nischayhegde/jetson_spi_to_can_x8_breakout/datasheets/README.md

# Datasheet archive

Local PDFs: **29/29 documents**, covering 26 component-library inventory part numbers plus 3 supplements.

A link is not a downloaded PDF. The status column records the actual local result. Documents may cover a family, and some are part-specific specification or characterization sheets as identified below.

| Part | Intended local filename | Document / source | Local status |
|---|---|---|---|
| MCP251863T-E/SS | MCP251863T-E_SS.pdf | [Microchip device datasheet](https://ww1.microchip.com/downloads/aemDocuments/documents/APID/ProductDocuments/DataSheets/MCP251863-Data-Sheet-DS20006624A.pdf) | present |
| ABM8G-40.000MHZ-18-D2Y-T | ABM8G-40.000MHZ-18-D2Y-T.pdf | [Abracon ABM8G family datasheet; selected options encoded in MPN](https://abracon.com/Resonators/ABM8G.pdf) | present |
| ESDONCAN1LT1G | ESDONCAN1LT1G.pdf | [onsemi ESDONCAN1 device datasheet, distributor-hosted older revision](https://www.farnell.com/datasheets/2337848.pdf) | present |
| ISO7763DWR | ISO7763DWR.pdf | [TI ISO776x family datasheet](https://www.ti.com/lit/ds/symlink/iso7763.pdf) | present |
| TMR 6-0511 | TMR_6-0511.pdf | [TRACO TMR 6 family datasheet](https://www.tracopower.com/products/tmr6.pdf) | present |
| TPS259530DSGR | TPS259530DSGR.pdf | [TI TPS2595 family datasheet](https://www.ti.com/lit/ds/symlink/tps2595.pdf) | present |
| TLV75533PDBVR | TLV75533PDBVR.pdf | [TI TLV755P family datasheet](https://www.ti.com/lit/ds/symlink/tlv755p.pdf) | present |
| CL10C270JB8NNNC | CL10C270JB8NNNC.pdf | [Samsung exact-part specification sheet, distributor-hosted copy; 27 pF C0G 50 V +/-5%, 0603](https://www1.futureelectronics.com/doc/Samsung%20Electro-Mechanics/CL10C270JB8NNNC.pdf) | present |
| CC0603KRX7R9BB104 | CC0603KRX7R9BB104.pdf | [YAGEO exact-part specification sheet](https://yageogroup.com/download/specsheet/CC0603KRX7R9BB104) | present |
| CGA3E1X7R1E105K080AC | CGA3E1X7R1E105K080AC.pdf | [TDK CGA series specification, distributor-hosted copy listing selected MPN](https://www.farnell.com/datasheets/1735392.pdf) | present |
| CL21B106KOQNNNE | CL21B106KOQNNNE.pdf | [Samsung CL series datasheet linked by DigiKey for selected MPN](https://mm.digikey.com/Volume0/opasdata/d220001/medias/docus/926/CL_Series_MLCC_ds.pdf) | present |
| CC0603KRX7R9BB103 | CC0603KRX7R9BB103.pdf | [YAGEO exact-part specification sheet](https://yageogroup.com/download/specsheet/CC0603KRX7R9BB103) | present |
| RC1206FR-07120RL | RC1206FR-07120RL.pdf | [YAGEO RC_L family datasheet](https://yageogroup.com/content/datasheet/asset/file/PYU-RC_GROUP_51_ROHS_L) | present |
| RC0603FR-0710KL | RC0603FR-0710KL.pdf | [YAGEO RC_L family datasheet](https://yageogroup.com/content/datasheet/asset/file/PYU-RC_GROUP_51_ROHS_L) | present |
| RC0603FR-0733RL | RC0603FR-0733RL.pdf | [YAGEO RC_L family datasheet](https://yageogroup.com/content/datasheet/asset/file/PYU-RC_GROUP_51_ROHS_L) | present |
| CRCW06031K21FKEA | CRCW06031K21FKEA.pdf | [Vishay D/CRCW e3 family datasheet](https://www.vishay.com/doc?20035=) | present |
| B3B-XH-A | B3B-XH-A.pdf | [JST XH series specification and dimensions](https://www.jst-mfg.com/product/pdf/eng/eXH.pdf) | present |
| B2B-XH-A | B2B-XH-A.pdf | [JST XH series specification and dimensions](https://www.jst-mfg.com/product/pdf/eng/eXH.pdf) | present |
| M20-9982046 | M20-9982046.pdf | [Harwin M20 component specification; also download M20-998 drawing](https://content.harwin.com/m/7d31e750480889aa/original/C001-C001XX-Component-Specification-M20-Series-2-54mm-pitch-PCB-connectors.pdf) | present |
| 0466001.NR | 0466001.NR.pdf | [Littelfuse 466 family datasheet, distributor-hosted copy including the selected 1 A row; current manufacturer link in BOM/symbol](https://www.farnell.com/datasheets/3741073.pdf) | present |
| AO3401A | AO3401A.pdf | [Alpha & Omega Semiconductor AO3401A Rev. 3.1 (December 2023), original manufacturer datasheet](https://www.aosmd.com/sites/default/files/res/datasheets/AO3401A.pdf) | present |
| BZT52C6V8-13-F | BZT52C6V8-13-F.pdf | [Diodes Incorporated DS18004 Rev. 32-2 (June 2008), DigiKey-hosted original manufacturer family datasheet including 6.8 V and -13-F packaging; current manufacturer sheet linked in BOM/symbol](https://media.digikey.com/pdf/Data%20Sheets/Diodes%20PDFs/BZT52CV0%20-%20BZT52C39.pdf) | present |
| 74LVC08APW,118 | 74LVC08APW_118.pdf | [Nexperia quad AND gate datasheet Rev. 11, distributor-hosted copy; latest Rev. 12 linked in symbol/BOM](https://store.comet.bg/download-file.php?id=14759) | present |
| 74AHC30PW,118 | 74AHC30PW_118.pdf | [Nexperia 74AHC/74AHCT30 older manufacturer datasheet from public mirror; current Rev. 8 reviewed online and linked in BOM/symbol](https://docs.ampnuts.ru/nexperia.com.datasheet/74AHC_AHCT30.pdf) | present |
| 74LVC32APW,118 | 74LVC32APW_118.pdf | [NXP 74LVC32A Rev. 5 (2011), distributor-hosted predecessor-brand datasheet; current Nexperia Rev. 11 linked in BOM/symbol](https://www.farnell.com/datasheets/1645516.pdf) | present |
| 74LVC04AT14-13 | 74LVC04AT14-13.pdf | [Diodes Incorporated hex inverter datasheet](https://www.diodes.com/assets/Datasheets/74LVC04A.pdf) | present |
| Supplement | M20-998_Drawing.pdf | [Harwin M20-998 family dimensional drawing](https://content.harwin.com/asset/1590d228-db5c-4836-ab0c-0f146730b624/DRG-00478-Technical-Drawing-Datasheet-M20-998-pdf.pdf) | present |
| Supplement | MCP251863_Board_Design_Hints.pdf | [Microchip board design application note](https://ww1.microchip.com/downloads/aemDocuments/documents/APID/ApplicationNotes/ApplicationNotes/MCP251863-Application-Note-00004560A.pdf) | present |
| Supplement | MOSFET_Reverse_Protection_TI.pdf | [TI Basics of Ideal Diodes, P-channel reverse-hookup topology and reverse-current limitations](https://www.ti.com/lit/an/slvae57/slvae57.pdf) | present |

## Download / retry

Run from the repository root:

```powershell
python .\datasheets\download_datasheets.py
```

The downloader uses ordinary system proxy settings; it does not bypass the environment network restrictions. It validates PDF header/trailer markers, preserves valid existing files, and records source URLs, timestamps, file sizes, hashes and errors. Full PDF rendering and electrical applicability still need review.

## Latest attempt

All listed PDFs are present.
