nischayhegde/jetson_spi_to_can_x8_breakout/review/MCP251863_Board_Design_Hints.txt

=== PDF PAGE 1 ===
 MCP251863 Schematic Hints
 MCP251863 Board Design Hints
Introduction
This application note covers hints on how to design a PCB for the MCP251863.
Included are recommendations to achieve a low level of emissions and best practices for other parts of the PCB.
A good EMC design requires more knowledge than what can be put into a short application note. Unlike many other
design issues, EMC is not an area where it is possible to list a set of rules. EMC compliance cannot be guaranteed
by design; it has to be tested.
© 2022 Microchip Technology Inc.
and its subsidiaries
 Manual
00004560A-page 1

=== PDF PAGE 2 ===
Table of Contents
Introduction.....................................................................................................................................................1
1. 
Getting Started........................................................................................................................................3
2. 
Examples - Schematic Excerpts MCP251863........................................................................................ 4
3. 
Related Documents.................................................................................................................................6
4. 
Revision History...................................................................................................................................... 7
Microchip Information.....................................................................................................................................8
The Microchip Website............................................................................................................................8
Product Change Notification Service...................................................................................................... 8
Customer Support...................................................................................................................................8
Microchip Devices Code Protection Feature...........................................................................................8
Legal Notice............................................................................................................................................ 8
Trademarks............................................................................................................................................. 9
Quality Management System................................................................................................................10
Worldwide Sales and Service................................................................................................................11
 MCP251863 schematic hints
© 2022 Microchip Technology Inc.
and its subsidiaries
 Manual
00004560A-page 2

=== PDF PAGE 3 ===
1.
Getting Started
Selecting the correct crystal oscillator or ceramic resonator components depends on multiple factors that are
application-dependent. Please review Section 6.7 “Clocking Guidelines” of the “PIC32 Family Reference Manual”
(DS61112) and refer to the application notes listed in Section Related Documents.
The following crystals, together with 18 pF load capacitors, were successfully used in two of our evaluation
boards: ABM8G-40.000MHZ-18-D2Y-T and ABM8G-20.000MHZ-18-D2Y-T. The following crystals, together with
6 pF load capacitors, were successfully used in our evaluation boards: XRCGE20M000F3A1AR0 and
XRCGB40M000F5A00R0. The CSTNR4M00GH5C000R0 ceramic resonator has been successfully tested with 39
pF load capacitors and a feedback resistor of 1 MΩ in one of our evaluation boards. The CSTNE20M0VH3C000R0
has been successfully tested with 15 pF load capacitors and a feedback resistor of 1 MΩ in one of our evaluation
boards.
Figure 1-1. CRYSTAL/CERAMIC RESONATOR OPERATION
OSC1
OSC2
4, 40 or 20 MHz
CLKIN, Crystal or
Ceramic Res.
40/20 MHz
PLLEN
OSCDIS
Divide
By 1, 2
SCLKDIV
SYSCLK
Divide
By 1, 2, 4, 10
CLKO
CLKODIV
PLL
x10
Optional
Feedback
Resistor
 MCP251863 Schematic Hints
Getting Started
© 2022 Microchip Technology Inc.
and its subsidiaries
 Manual
00004560A-page 3

=== PDF PAGE 4 ===
2.
Examples - Schematic Excerpts MCP251863
There are several sections of the layout that are crucial for a good EMC performance. This chapter gives examples of
how to properly implement these.
The first section is the external crystal-oscillator. The suggested schematic in the datasheet includes R13 and R14
that may or may not be necessary for stability, depending on the crystal-oscillator being used. If the specific design
does not need them, the crystal can be moved closer to the MCP251863.
Figure 2-1. MCP251863 Oscillator schematic
Q11
GND
10p
C12
10p
C11
0R
R14
DNP
R13
OSC2
20
OSC1
21
GND
GND
MCP251863
40 MHz
It is important to place the crystal-oscillator as close as possible to the MCP251863. It is recommended to keep the
traces on the same side of the PCB as the crystal-oscillator and the MCP251863.
Figure 2-2. MCP251863 Oscillator layout
C12
C11
R14
R13
The most crucial section to achieve a low level of emissions is the power supply. The VDD input is blocked with one
or two capacitors depending on the requirements of the board. If two capacitors are used, the one with the smaller
value should be placed closer to the MCP251863.
Figure 2-3. MCP251863 power schematic
100nF
C14
10nF
C15
VDD
VSS
22
VDD
14
GND
GND
GND
MCP251863
It is highly recommended that a direct and low-impedance connection from the Ground pin 22 to the blocking
capacitor is implemented and that the ground vias are placed close to the blocking capacitor. Simply connecting pin
22 to a large Ground plane and placing a via close-by significantly increases unwanted emissions.
 MCP251863 Schematic Hints
Examples - Schematic Excerpts MCP251863
© 2022 Microchip Technology Inc.
and its subsidiaries
 Manual
00004560A-page 4

=== PDF PAGE 5 ===
Figure 2-4. MCP251863 power layout
C15
U1
 MCP251863 Schematic Hints
Examples - Schematic Excerpts MCP251863
© 2022 Microchip Technology Inc.
and its subsidiaries
 Manual
00004560A-page 5

=== PDF PAGE 6 ===
3.
Related Documents
MCP251863 webpage
PIC32 Family Reference Manual "Section 6. "Oscillators"
Basic PICmicro Oscillator Design
Practical PICmicro® Oscillator Analysis and Design
CISPR standards: 16, 22 and 25
 MCP251863 Schematic Hints
Related Documents
© 2022 Microchip Technology Inc.
and its subsidiaries
 Manual
00004560A-page 6

=== PDF PAGE 7 ===
4.
Revision History
Rev A – 05/2022
Initial Release
 MCP251863 Schematic Hints
Revision History
© 2022 Microchip Technology Inc.
and its subsidiaries
 Manual
00004560A-page 7

=== PDF PAGE 8 ===
Microchip Information
The Microchip Website
Microchip provides online support via our website at www.microchip.com/. This website is used to make files and
information easily available to customers. Some of the content available includes:
•
Product Support – Data sheets and errata, application notes and sample programs, design resources, user’s
guides and hardware support documents, latest software releases and archived software
•
General Technical Support – Frequently Asked Questions (FAQs), technical support requests, online
discussion groups, Microchip design partner program member listing
•
Business of Microchip – Product selector and ordering guides, latest Microchip press releases, listing of
seminars and events, listings of Microchip sales offices, distributors and factory representatives
Product Change Notification Service
Microchip’s product change notification service helps keep customers current on Microchip products. Subscribers will
receive email notification whenever there are changes, updates, revisions or errata related to a specified product
family or development tool of interest.
To register, go to www.microchip.com/pcn and follow the registration instructions.
Customer Support
Users of Microchip products can receive assistance through several channels:
•
Distributor or Representative
•
Local Sales Office
•
Embedded Solutions Engineer (ESE)
•
Technical Support
Customers should contact their distributor, representative or ESE for support. Local sales offices are also available to
help customers. A listing of sales offices and locations is included in this document.
Technical support is available through the website at: www.microchip.com/support
Microchip Devices Code Protection Feature
Note the following details of the code protection feature on Microchip products:
•
Microchip products meet the specifications contained in their particular Microchip Data Sheet.
•
Microchip believes that its family of products is secure when used in the intended manner, within operating
specifications, and under normal conditions.
•
Microchip values and aggressively protects its intellectual property rights. Attempts to breach the code
protection features of Microchip product is strictly prohibited and may violate the Digital Millennium Copyright
Act.
•
Neither Microchip nor any other semiconductor manufacturer can guarantee the security of its code. Code
protection does not mean that we are guaranteeing the product is “unbreakable”. Code protection is constantly
evolving. Microchip is committed to continuously improving the code protection features of our products.
Legal Notice
This publication and the information herein may be used only with Microchip products, including to design, test,
and integrate Microchip products with your application. Use of this information in any other manner violates these
terms. Information regarding device applications is provided only for your convenience and may be superseded
 MCP251863 Schematic Hints
© 2022 Microchip Technology Inc.
and its subsidiaries
 Manual
00004560A-page 8

=== PDF PAGE 9 ===
by updates. It is your responsibility to ensure that your application meets with your specifications. Contact your
local Microchip sales office for additional support or, obtain additional support at www.microchip.com/en-us/support/
design-help/client-support-services.
THIS INFORMATION IS PROVIDED BY MICROCHIP "AS IS". MICROCHIP MAKES NO REPRESENTATIONS
OR WARRANTIES OF ANY KIND WHETHER EXPRESS OR IMPLIED, WRITTEN OR ORAL, STATUTORY
OR OTHERWISE, RELATED TO THE INFORMATION INCLUDING BUT NOT LIMITED TO ANY IMPLIED
WARRANTIES OF NON-INFRINGEMENT, MERCHANTABILITY, AND FITNESS FOR A PARTICULAR PURPOSE,
OR WARRANTIES RELATED TO ITS CONDITION, QUALITY, OR PERFORMANCE.
IN NO EVENT WILL MICROCHIP BE LIABLE FOR ANY INDIRECT, SPECIAL, PUNITIVE, INCIDENTAL, OR
CONSEQUENTIAL LOSS, DAMAGE, COST, OR EXPENSE OF ANY KIND WHATSOEVER RELATED TO THE
INFORMATION OR ITS USE, HOWEVER CAUSED, EVEN IF MICROCHIP HAS BEEN ADVISED OF THE
POSSIBILITY OR THE DAMAGES ARE FORESEEABLE. TO THE FULLEST EXTENT ALLOWED BY LAW,
MICROCHIP'S TOTAL LIABILITY ON ALL CLAIMS IN ANY WAY RELATED TO THE INFORMATION OR ITS USE
WILL NOT EXCEED THE AMOUNT OF FEES, IF ANY, THAT YOU HAVE PAID DIRECTLY TO MICROCHIP FOR
THE INFORMATION.
Use of Microchip devices in life support and/or safety applications is entirely at the buyer's risk, and the buyer agrees
to defend, indemnify and hold harmless Microchip from any and all damages, claims, suits, or expenses resulting
from such use. No licenses are conveyed, implicitly or otherwise, under any Microchip intellectual property rights
unless otherwise stated.
Trademarks
The Microchip name and logo, the Microchip logo, Adaptec, AnyRate, AVR, AVR logo, AVR Freaks, BesTime,
BitCloud, CryptoMemory, CryptoRF, dsPIC, flexPWR, HELDO, IGLOO, JukeBlox, KeeLoq, Kleer, LANCheck,
LinkMD, maXStylus, maXTouch, MediaLB, megaAVR, Microsemi, Microsemi logo, MOST, MOST logo, MPLAB,
OptoLyzer, PIC, picoPower, PICSTART, PIC32 logo, PolarFire, Prochip Designer, QTouch, SAM-BA, SenGenuity,
SpyNIC, SST, SST Logo, SuperFlash, Symmetricom, SyncServer, Tachyon, TimeSource, tinyAVR, UNI/O, Vectron,
and XMEGA are registered trademarks of Microchip Technology Incorporated in the U.S.A. and other countries.
AgileSwitch, APT, ClockWorks, The Embedded Control Solutions Company, EtherSynch, Flashtec, Hyper Speed
Control, HyperLight Load, IntelliMOS, Libero, motorBench, mTouch, Powermite 3, Precision Edge, ProASIC, ProASIC
Plus, ProASIC Plus logo, Quiet- Wire, SmartFusion, SyncWorld, Temux, TimeCesium, TimeHub, TimePictra,
TimeProvider, TrueTime, WinPath, and ZL are registered trademarks of Microchip Technology Incorporated in the
U.S.A.
Adjacent Key Suppression, AKS, Analog-for-the-Digital Age, Any Capacitor, AnyIn, AnyOut, Augmented Switching,
BlueSky, BodyCom, CodeGuard, CryptoAuthentication, CryptoAutomotive, CryptoCompanion, CryptoController,
dsPICDEM, dsPICDEM.net, Dynamic Average Matching, DAM, ECAN, Espresso T1S, EtherGREEN, GridTime,
IdealBridge, In-Circuit Serial Programming, ICSP, INICnet, Intelligent Paralleling, Inter-Chip Connectivity,
JitterBlocker, Knob-on-Display, maxCrypto, maxView, memBrain, Mindi, MiWi, MPASM, MPF, MPLAB Certified
logo, MPLIB, MPLINK, MultiTRAK, NetDetach, NVM Express, NVMe, Omniscient Code Generation, PICDEM,
PICDEM.net, PICkit, PICtail, PowerSmart, PureSilicon, QMatrix, REAL ICE, Ripple Blocker, RTAX, RTG4, SAM-
ICE, Serial Quad I/O, simpleMAP, SimpliPHY, SmartBuffer, SmartHLS, SMART-I.S., storClad, SQI, SuperSwitcher,
SuperSwitcher II, Switchtec, SynchroPHY, Total Endurance, TSHARC, USBCheck, VariSense, VectorBlox, VeriPHY,
ViewSpan, WiperLock, XpressConnect, and ZENA are trademarks of Microchip Technology Incorporated in the
U.S.A. and other countries.
SQTP is a service mark of Microchip Technology Incorporated in the U.S.A.
The Adaptec logo, Frequency on Demand, Silicon Storage Technology, Symmcom, and Trusted Time are registered
trademarks of Microchip Technology Inc. in other countries.
GestIC is a registered trademark of Microchip Technology Germany II GmbH & Co. KG, a subsidiary of Microchip
Technology Inc., in other countries.
All other trademarks mentioned herein are property of their respective companies.
© 2022, Microchip Technology Incorporated and its subsidiaries. All Rights Reserved.
ISBN: 978-1-6683-0438-9
 MCP251863 Schematic Hints
© 2022 Microchip Technology Inc.
and its subsidiaries
 Manual
00004560A-page 9

=== PDF PAGE 10 ===
Quality Management System
For information regarding Microchip’s Quality Management Systems, please visit www.microchip.com/quality.
 MCP251863 Schematic Hints
© 2022 Microchip Technology Inc.
and its subsidiaries
 Manual
00004560A-page 10

=== PDF PAGE 11 ===
AMERICAS
ASIA/PACIFIC
ASIA/PACIFIC
EUROPE
Corporate Office
2355 West Chandler Blvd.
Chandler, AZ 85224-6199
Tel: 480-792-7200
Fax: 480-792-7277
Technical Support:
www.microchip.com/support
Web Address:
www.microchip.com
Atlanta
Duluth, GA
Tel: 678-957-9614
Fax: 678-957-1455
Austin, TX
Tel: 512-257-3370
Boston
Westborough, MA
Tel: 774-760-0087
Fax: 774-760-0088
Chicago
Itasca, IL
Tel: 630-285-0071
Fax: 630-285-0075
Dallas
Addison, TX
Tel: 972-818-7423
Fax: 972-818-2924
Detroit
Novi, MI
Tel: 248-848-4000
Houston, TX
Tel: 281-894-5983
Indianapolis
Noblesville, IN
Tel: 317-773-8323
Fax: 317-773-5453
Tel: 317-536-2380
Los Angeles
Mission Viejo, CA
Tel: 949-462-9523
Fax: 949-462-9608
Tel: 951-273-7800
Raleigh, NC
Tel: 919-844-7510
New York, NY
Tel: 631-435-6000
San Jose, CA
Tel: 408-735-9110
Tel: 408-436-4270
Canada - Toronto
Tel: 905-695-1980
Fax: 905-695-2078
Australia - Sydney
Tel: 61-2-9868-6733
China - Beijing
Tel: 86-10-8569-7000
China - Chengdu
Tel: 86-28-8665-5511
China - Chongqing
Tel: 86-23-8980-9588
China - Dongguan
Tel: 86-769-8702-9880
China - Guangzhou
Tel: 86-20-8755-8029
China - Hangzhou
Tel: 86-571-8792-8115
China - Hong Kong SAR
Tel: 852-2943-5100
China - Nanjing
Tel: 86-25-8473-2460
China - Qingdao
Tel: 86-532-8502-7355
China - Shanghai
Tel: 86-21-3326-8000
China - Shenyang
Tel: 86-24-2334-2829
China - Shenzhen
Tel: 86-755-8864-2200
China - Suzhou
Tel: 86-186-6233-1526
China - Wuhan
Tel: 86-27-5980-5300
China - Xian
Tel: 86-29-8833-7252
China - Xiamen
Tel: 86-592-2388138
China - Zhuhai
Tel: 86-756-3210040
India - Bangalore
Tel: 91-80-3090-4444
India - New Delhi
Tel: 91-11-4160-8631
India - Pune
Tel: 91-20-4121-0141
Japan - Osaka
Tel: 81-6-6152-7160
Japan - Tokyo
Tel: 81-3-6880- 3770
Korea - Daegu
Tel: 82-53-744-4301
Korea - Seoul
Tel: 82-2-554-7200
Malaysia - Kuala Lumpur
Tel: 60-3-7651-7906
Malaysia - Penang
Tel: 60-4-227-8870
Philippines - Manila
Tel: 63-2-634-9065
Singapore
Tel: 65-6334-8870
Taiwan - Hsin Chu
Tel: 886-3-577-8366
Taiwan - Kaohsiung
Tel: 886-7-213-7830
Taiwan - Taipei
Tel: 886-2-2508-8600
Thailand - Bangkok
Tel: 66-2-694-1351
Vietnam - Ho Chi Minh
Tel: 84-28-5448-2100
Austria - Wels
Tel: 43-7242-2244-39
Fax: 43-7242-2244-393
Denmark - Copenhagen
Tel: 45-4485-5910
Fax: 45-4485-2829
Finland - Espoo
Tel: 358-9-4520-820
France - Paris
Tel: 33-1-69-53-63-20
Fax: 33-1-69-30-90-79
Germany - Garching
Tel: 49-8931-9700
Germany - Haan
Tel: 49-2129-3766400
Germany - Heilbronn
Tel: 49-7131-72400
Germany - Karlsruhe
Tel: 49-721-625370
Germany - Munich
Tel: 49-89-627-144-0
Fax: 49-89-627-144-44
Germany - Rosenheim
Tel: 49-8031-354-560
Israel - Ra’anana
Tel: 972-9-744-7705
Italy - Milan
Tel: 39-0331-742611
Fax: 39-0331-466781
Italy - Padova
Tel: 39-049-7625286
Netherlands - Drunen
Tel: 31-416-690399
Fax: 31-416-690340
Norway - Trondheim
Tel: 47-72884388
Poland - Warsaw
Tel: 48-22-3325737
Romania - Bucharest
Tel: 40-21-407-87-50
Spain - Madrid
Tel: 34-91-708-08-90
Fax: 34-91-708-08-91
Sweden - Gothenberg
Tel: 46-31-704-60-40
Sweden - Stockholm
Tel: 46-8-5090-4654
UK - Wokingham
Tel: 44-118-921-5800
Fax: 44-118-921-5820
Worldwide Sales and Service
© 2022 Microchip Technology Inc.
and its subsidiaries
 Manual
00004560A-page 11
