nischayhegde/jetson_spi_to_can_x8_breakout/fabrication/2026-10-29/drill-report.txt

Drill report for breakout.kicad_pcb
Created on 2026-10-29T21:05:50

Copper Layer Stackup:
    =============================================================
    L1 :  Top                       front
    L2 :  GND                       in1
    L3 :  PWR                       in2
    L4 :  Bottom                    back

Drill file 'breakout-PTH.drl' contains
    plated through holes:
    =============================================================
    T1  0.300mm  0.0118"  (207 holes))
    T2  0.950mm  0.0374"  (24 holes))
    T3  1.000mm  0.0394"  (46 holes))

    Total plated holes count 277

Drill file 'breakout-NPTH.drl' contains
    unplated through holes:
    =============================================================
    T1  3.200mm  0.1260"  (4 holes))

    Total unplated holes count 4
