nischayhegde/jetson_spi_to_can_x8_breakout/jetsonpinout.png

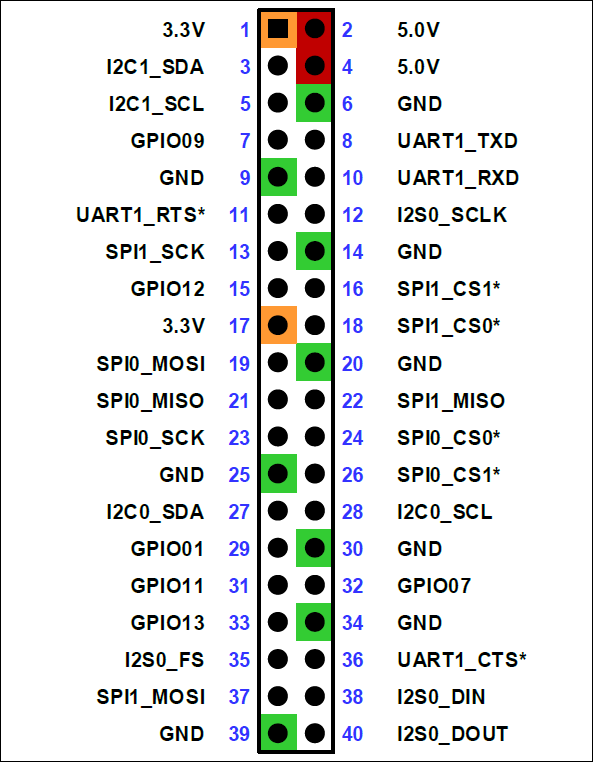
jetsonpinout.png
