nischayhegde/jetson_spi_to_can_x8_breakout/kicad_footprints/validation/input_diode_pinout.png

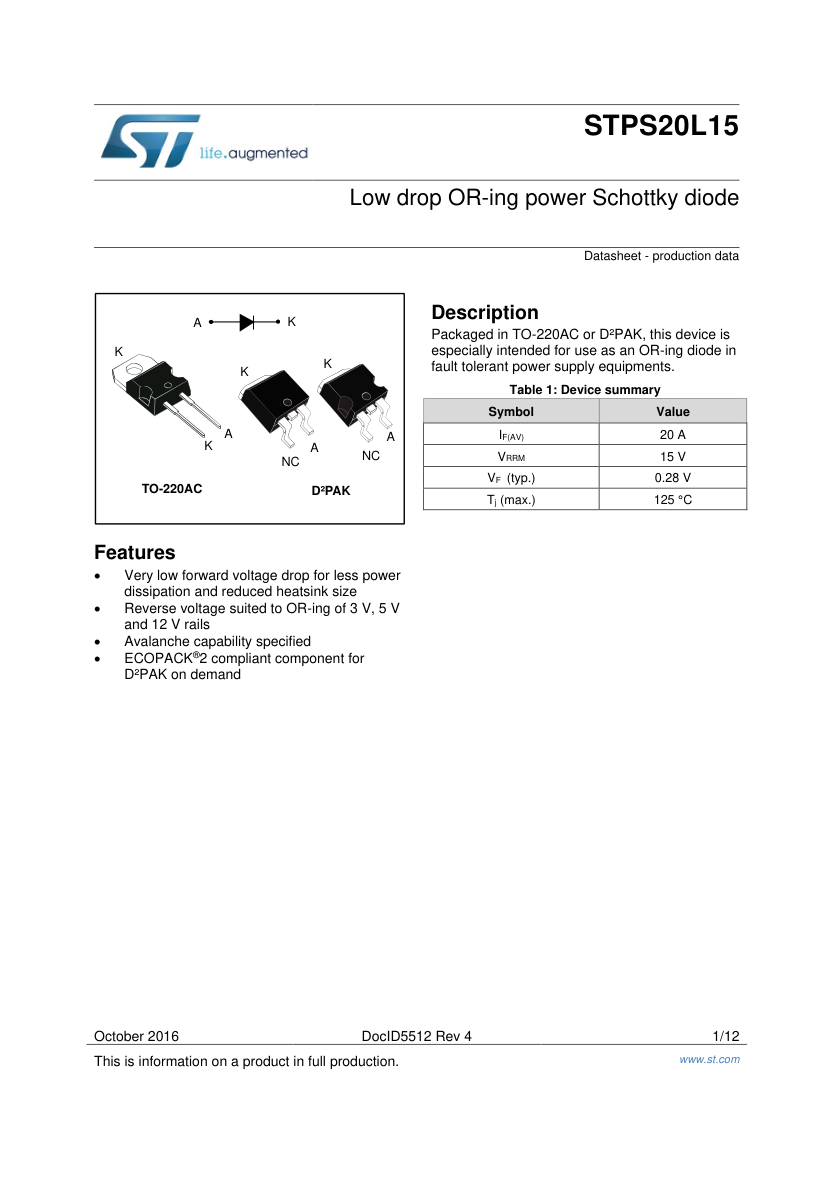
kicad_footprints/validation/input_diode_pinout.png
