nischayhegde/jetson_spi_to_can_x8_breakout/review/AO3401A_pinout.png

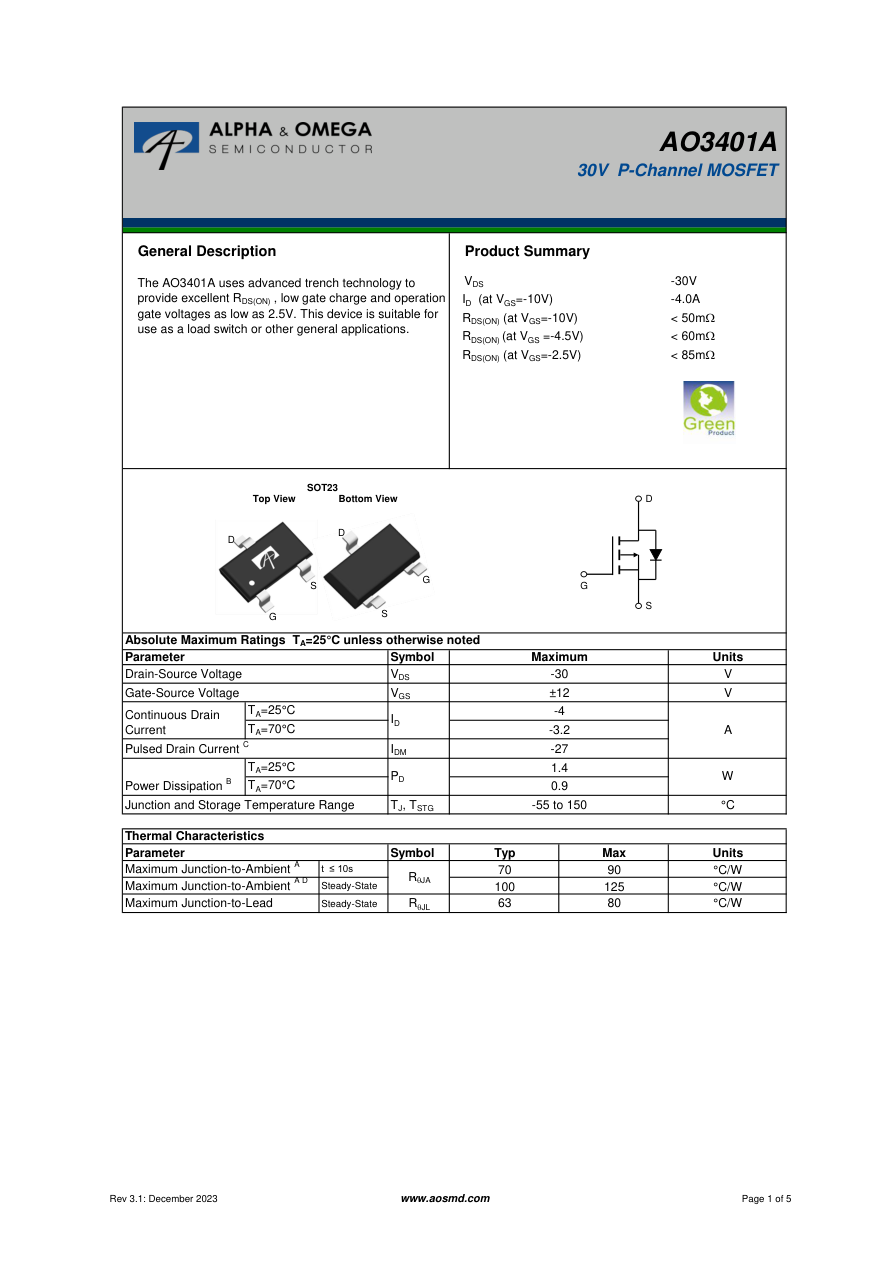
review/AO3401A_pinout.png
