nischayhegde/jetson_spi_to_can_x8_breakout/review/j1-ground-fix-2026-10-25/j1-schematic.png

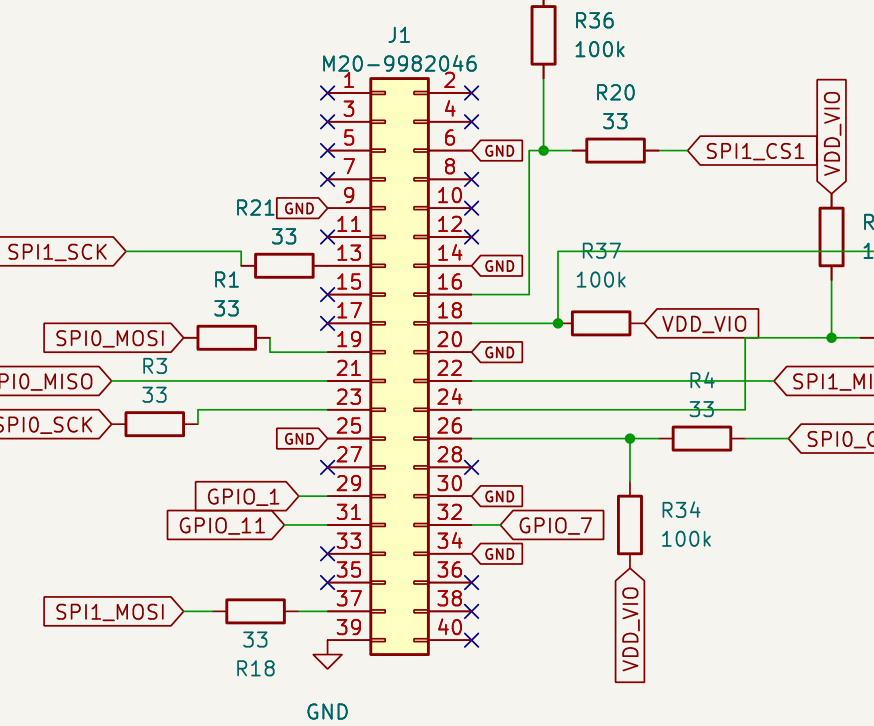
review/j1-ground-fix-2026-10-25/j1-schematic.png
