nischayhegde/jetson_spi_to_can_x8_breakout/review/latest/can_spi1.png

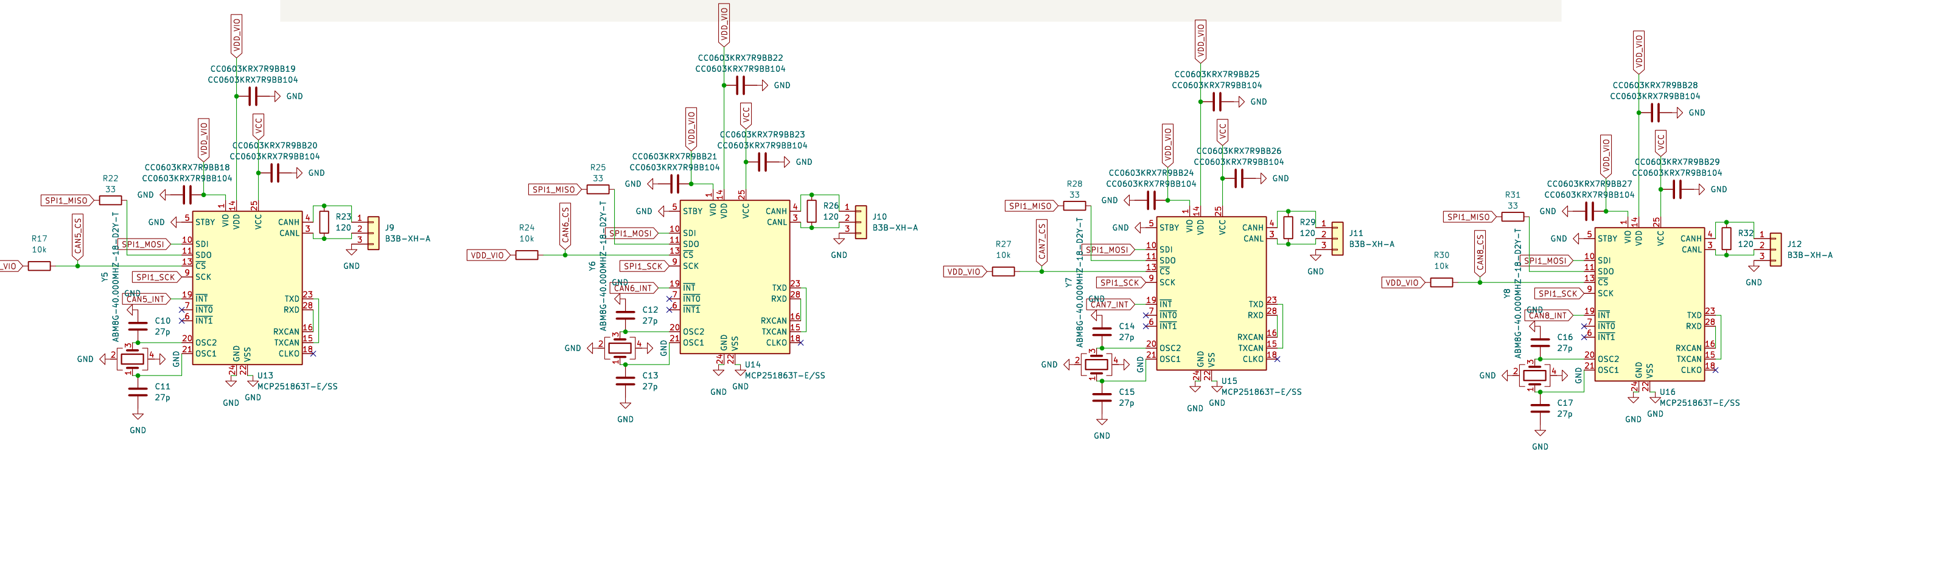
review/latest/can_spi1.png
