nischayhegde/jetson_spi_to_can_x8_breakout/review/latest/schematic.png

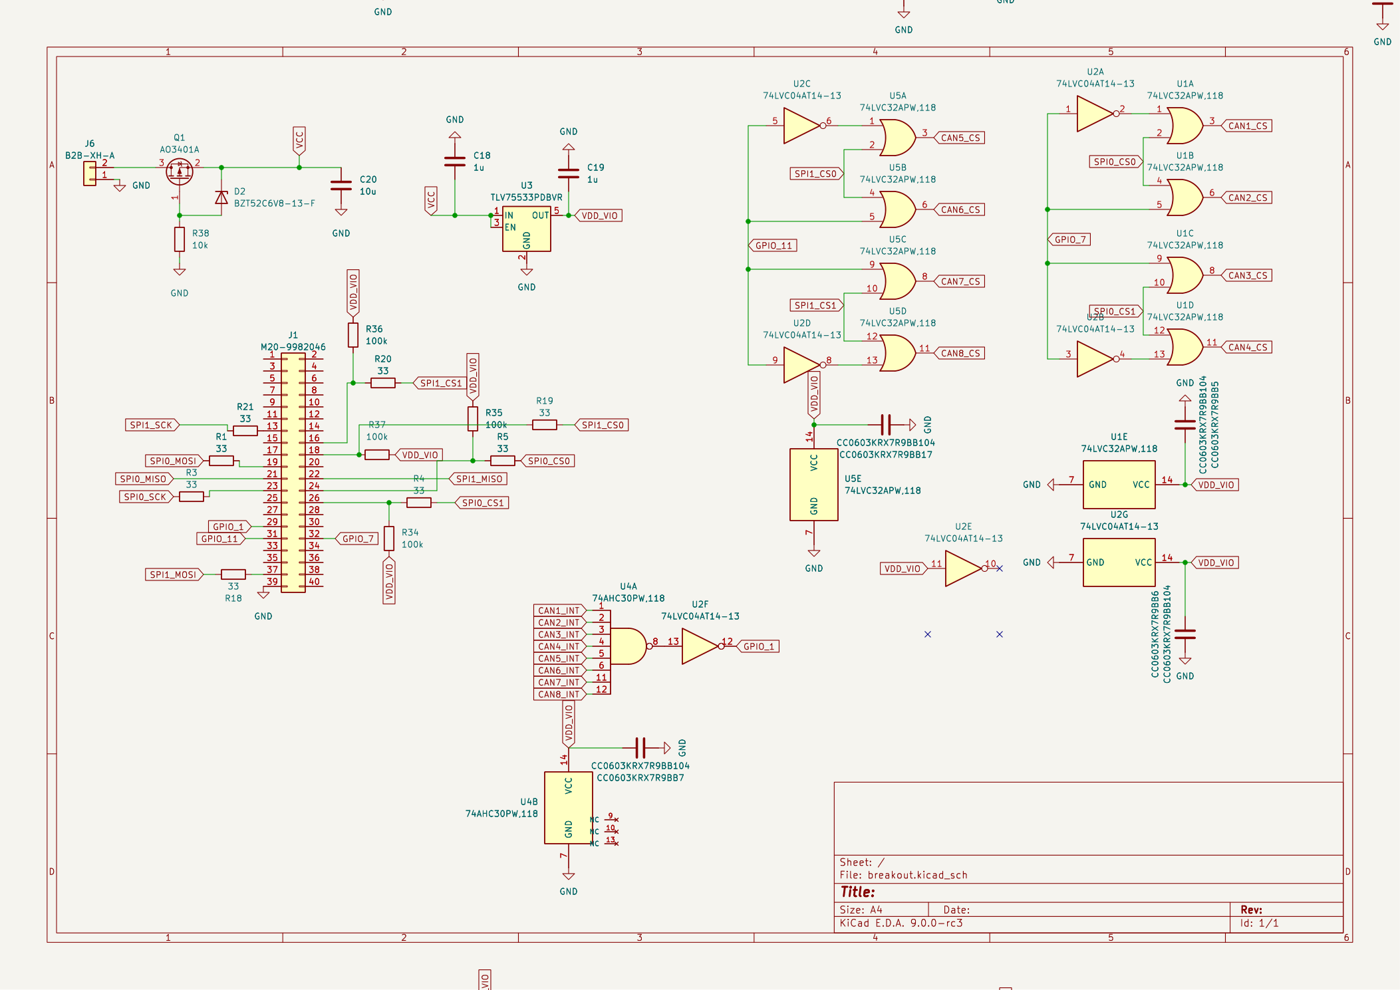
review/latest/schematic.png
