nischayhegde/jetson_spi_to_can_x8_breakout/review/mounting-holes-2026-10-29/after-front.png

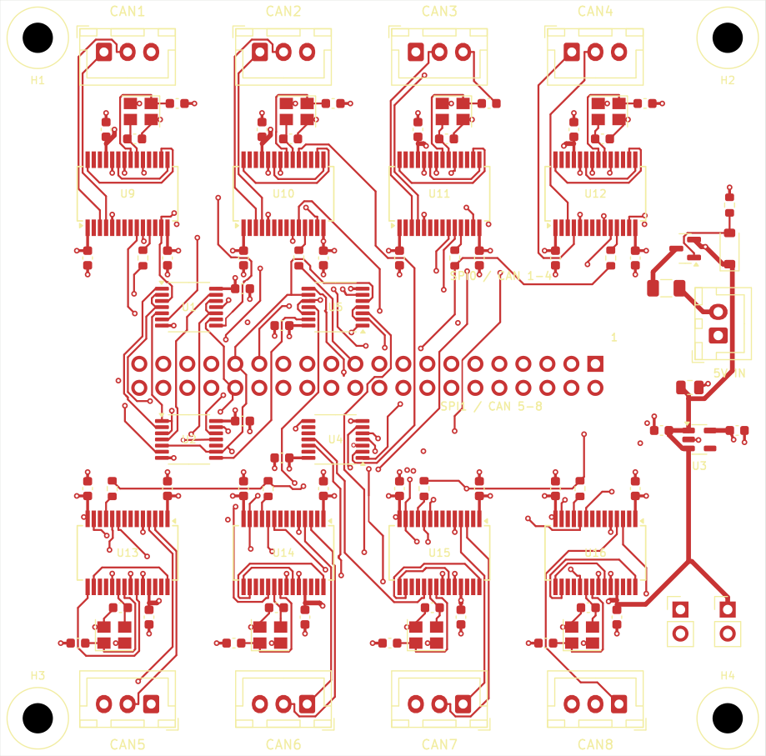
review/mounting-holes-2026-10-29/after-front.png
