nischayhegde/jetson_spi_to_can_x8_breakout/review/mounting-holes-2026-10-29/layout-preview.png

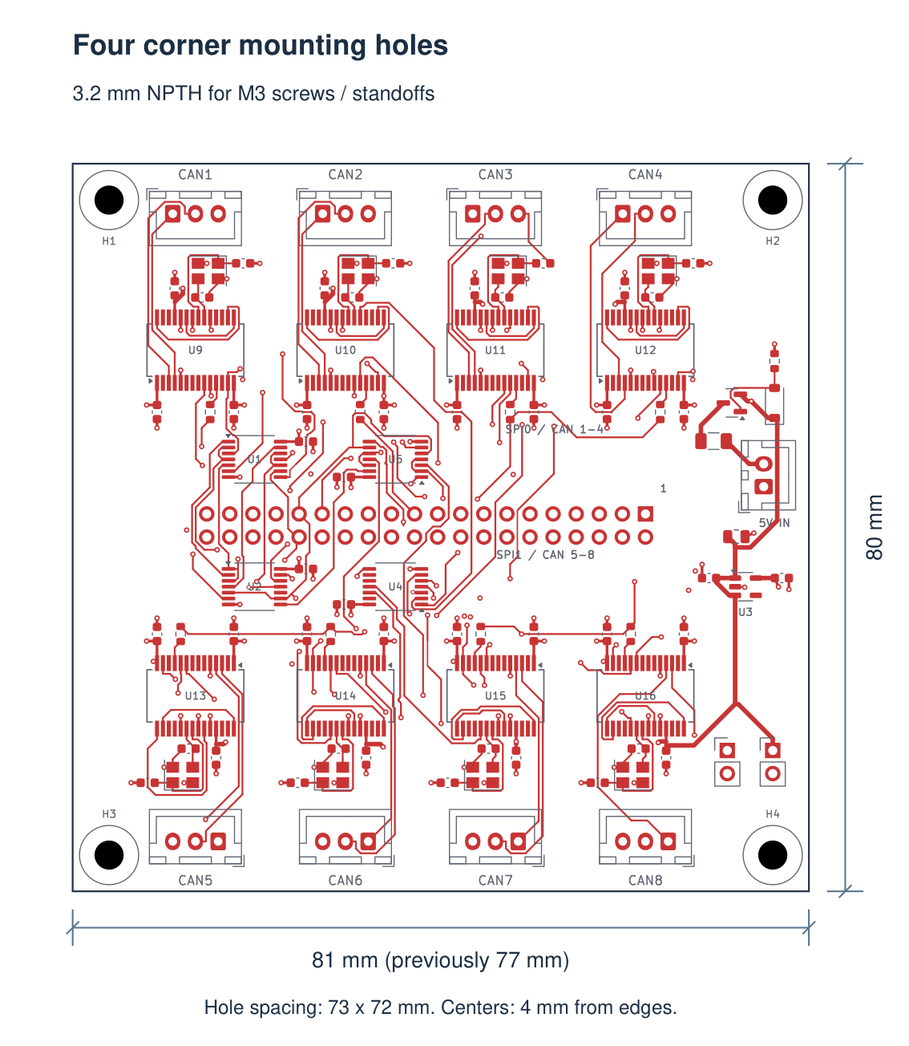
review/mounting-holes-2026-10-29/layout-preview.png
