nischayhegde/jetson_spi_to_can_x8_breakout/review/standardization-2026-10-29/r26-back.png

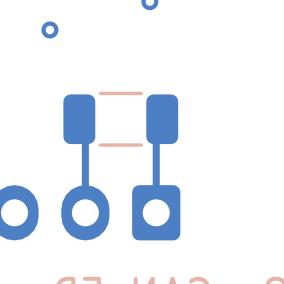
review/standardization-2026-10-29/r26-back.png
