nischayhegde/jetson_spi_to_can_x8_breakout/v1screenshots/ss7.png

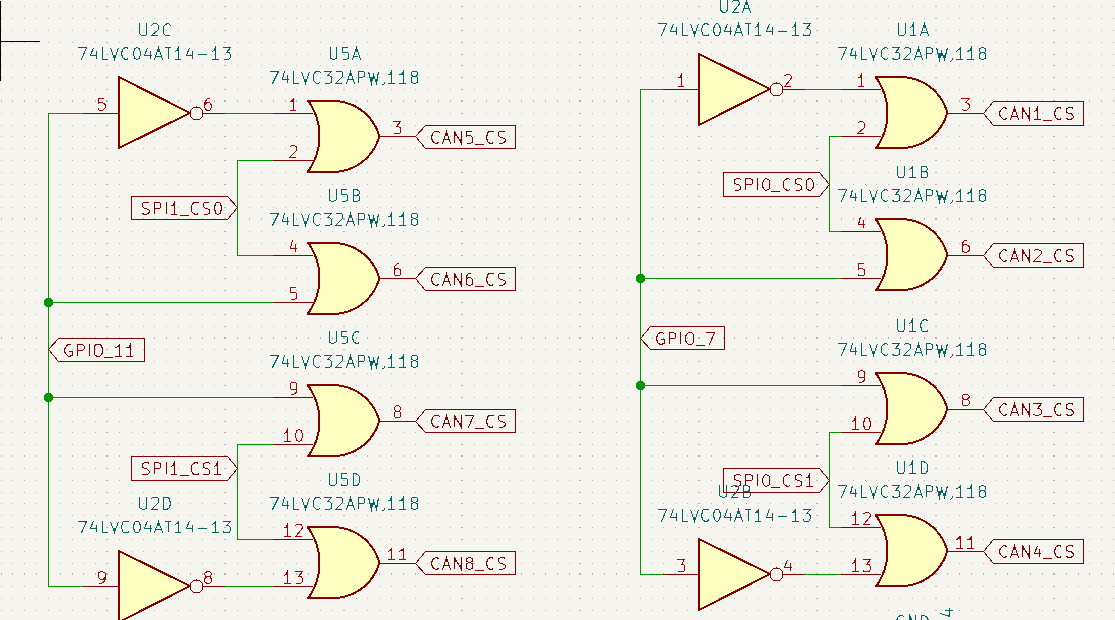
v1screenshots/ss7.png
