nischayhegde/jetson_spi_to_can_x8_breakout/componentlist.md.txt

# SPI to eight-channel CAN PCB component list

Updated 2026-10-30 from the saved schematic and PCB, with the approved purchasing substitutions below. Quantities are fitted packages for one board; multi-unit logic ICs count only once.

**21 purchase lines, 120 fitted components.** The PCB also contains 21 bare test pads and four mounting holes, which need no purchased component. References, quantities and footprints come from the saved CAD. The CSV records both the part to purchase and the original CAD MPN.

**10 kohm replacement:** purchase **AC0603FR-0710KL** for R7/R8/R11/R14/R17/R24/R27/R30/R38. The original RC0603FR-0710KL is out of stock at DigiKey. The replacement is YAGEO, 10 kohm, 1%, 0.1 W, 0603, with the same nominal 1.60 x 0.80 x 0.45 mm body and 100 ppm/C TCR. It fits the existing footprint. The schematic, PCB and fabrication ZIP are unchanged. [Manufacturer datasheet](https://yageogroup.com/content/datasheet/asset/file/PYU-AC_51_ROHS_L).

**100 kohm replacement:** purchase **CRCW0603100KFKEA** for R34-R37. The original RC0603FR-07100KL is on backorder at DigiKey. The Vishay part is 100 kohm, 1%, 100 ppm/C and 0603, with a 0.1 W standard rating (0.125 W extended). Its nominal 1.55 x 0.85 x 0.45 mm body fits the existing 0603 footprint. Order five: four fitted and one spare. [Manufacturer datasheet](https://www.vishay.com/docs/20035/dcrcwe3.pdf).

**Standardized parts:** all eight 120-ohm CAN terminations use **RC1206FR-07120RL**, 1%, 0.25 W, 1206. J1 uses **M20-7832046** and the matching female socket footprint in the schematic, PCB and order list. [YAGEO resistor specification](https://yageogroup.com/component-documentation/download/specsheet/RC1206FR-07120RL); [Harwin socket specification](https://www.harwin.com/products/M20-7832046).

| Function | Manufacturer part to purchase | Qty | References | Existing PCB footprint | Mouser | DigiKey |
|---|---|---:|---|---|---|---|
| CAN controller/transceiver | MCP251863T-E/SS | 8 | U9, U10, U11, U12, U13, U14, U15, U16 | BreakoutBoard:SSOP-28_5.3x10.2mm_P0.65mm | [Listing](https://www.mouser.com/en/ProductDetail/Microchip-Technology/MCP251863T-E-SS?qs=doiCPypUmgEjABEwFke1cA%3D%3D) | [Listing](https://www.digikey.com/en/products/detail/microchip-technology/MCP251863T-E-SS/15985723) |
| 40 MHz crystal | ABM8G-40.000MHZ-18-D2Y-T | 8 | Y1, Y2, Y3, Y4, Y5, Y6, Y7, Y8 | BreakoutBoard:Crystal_SMD_Abracon_ABM8G-4Pin_3.2x2.5mm | [Listing](https://www.mouser.com/en/ProductDetail/ABRACON/ABM8G-40.000MHZ-18-D2Y-T?qs=3LVMET7lfiO1sAQRIVmcWA%3D%3D) | [Listing](https://www.digikey.com/en/products/detail/abracon-llc/ABM8G-40-000MHZ-18-D2Y-T/2218027) |
| 3.3 V LDO | TLV75533PDBVR | 1 | U3 | BreakoutBoard:SOT-23-5 | [Listing](https://www.mouser.com/en/ProductDetail/Texas-Instruments/TLV75533PDBVR?qs=55YtniHzbhAKEwqeO2xJXQ%3D%3D) | [Listing](https://www.digikey.com/en/products/detail/texas-instruments/TLV75533PDBVR/9356541) |
| Crystal load capacitor | CL10C270JB8NNNC | 16 | C2, C3, C4, C5, C6, C7, C8, C9, C10, C11, C12, C13, C14, C15, C16, C17 | Capacitor_SMD:C_0603_1608Metric | [Listing](https://www.mouser.it/ProductDetail/Samsung-Electro-Mechanics/CL10C270JB8NNNC?qs=349EhDEZ59qQ7Bw6gEHQYQ%3D%3D) | [Listing](https://www.digikey.com/en/products/detail/samsung-electro-mechanics/CL10C270JB8NNNC/3889172) |
| Local bypass capacitor | CC0603KRX7R9BB104 | 28 | C1, C21, C22, C23, C24, C25, C26, C27, C28, C29, C30, C31, C32, C33, C34, C35, C36, C37, C38, C39, C40, C41, C42, C43, C44, C45, C46, C47 | BreakoutBoard:C_0603_1608Metric | [Listing](https://www.mouser.com/en/ProductDetail/YAGEO/CC0603KRX7R9BB104?qs=vTakOoo5QyLvVCYM2ge8LQ%3D%3D) | [Listing](https://www.digikey.com/en/products/detail/yageo/CC0603KRX7R9BB104/2103082) |
| LDO input/output capacitor | CGA3E1X7R1E105K080AC | 2 | C18, C19 | BreakoutBoard:C_0603_1608Metric | [Listing](https://www.mouser.com/en/ProductDetail/TDK/CGA3E1X7R1E105K080AC?qs=NRhsANhppD9VxGl2AsmRpw%3D%3D) | [Listing](https://www.digikey.com/en/products/detail/tdk/CGA3E1X7R1E105K080AC/2672949) |
| Protected-input bulk capacitor | CL21B106KOQNNNE | 1 | C20 | BreakoutBoard:C_0805_2012Metric | [Listing](https://www.mouser.com/en/ProductDetail/Samsung-Electro-Mechanics/CL21B106KOQNNNE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) | [Listing](https://www.digikey.com/en/products/detail/samsung-electro-mechanics/CL21B106KOQNNNE/3888530) |
| Fixed CAN termination | RC1206FR-07120RL | 8 | R6, R10, R13, R16, R23, R26, R29, R32 | BreakoutBoard:R_1206_3216Metric | [Listing](https://www.mouser.com/en/ProductDetail/YAGEO/RC1206FR-07120RL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) | [Listing](https://www.digikey.com/en/products/detail/yageo/RC1206FR-07120RL/728523) |
| CAN nCS pull-ups / MOSFET gate pull-down | AC0603FR-0710KL | 9 | R7, R8, R11, R14, R17, R24, R27, R30, R38 | BreakoutBoard:R_0603_1608Metric | [Listing](https://my.mouser.com/ProductDetail/YAGEO/AC0603FR-0710KL?qs=UoPT7wUmgYKz3zh0UDMA4Q%3D%3D) | [Listing](https://www.digikey.com/en/products/detail/yageo/AC0603FR-0710KL/2828135) |
| Native Jetson CS pull-ups | CRCW0603100KFKEA | 4 | R34, R35, R36, R37 | BreakoutBoard:R_0603_1608Metric | [Listing](https://www.mouser.com/en/ProductDetail/Vishay/CRCW0603100KFKEA?qs=6dqgS%252BKntICWHMMdIzt5%2FQ%3D%3D) | [Listing](https://www.digikey.com/en/products/detail/vishay-dale/CRCW0603100KFKEA/1174896) |
| SPI series damping | RC0603FR-0733RL | 16 | R1, R2, R3, R4, R5, R9, R12, R15, R18, R19, R20, R21, R22, R25, R28, R31 | BreakoutBoard:R_0603_1608Metric | [Listing](https://www.mouser.com/en/ProductDetail/YAGEO/RC0603FR-0733RL?qs=diQw95jMAeMotgif2GSHTQ%3D%3D) | [Listing](https://www.digikey.com/en/products/detail/yageo/RC0603FR-0733RL/730105) |
| CAN connector | B3B-XH-A | 8 | J4, J5, J7, J8, J9, J10, J11, J12 | BreakoutBoard:JST_XH_B3B-XH-A_1x03_P2.50mm_Vertical | [Listing](https://www.mouser.com/en/ProductDetail/JST-Commercial/B3B-XH-ALFSN?qs=cdbOS8ANM9BVkoboCCIEMQ%3D%3D) | [Listing](https://www.digikey.com/en/products/detail/jst-sales-america-inc/B3B-XH-A/1651046) |
| 5 V input connector | B2B-XH-A | 1 | J6 | BreakoutBoard:JST_XH_B2B-XH-A_1x02_P2.50mm_Vertical | [Listing](https://www.mouser.com/en/ProductDetail/JST-Commercial/B2B-XH-ALFSN?qs=cdbOS8ANM9DdcSn9qRmfCw%3D%3D) | [Listing](https://www.digikey.com/en/products/detail/jst-sales-america-inc/B2B-XH-A/1651045) |
| Jetson 40-pin female socket | M20-7832046 | 1 | J1 | Connector_PinSocket_2.54mm:PinSocket_2x20_P2.54mm_Vertical | [Listing](https://www.mouser.com/en/ProductDetail/Harwin/M20-7832046?qs=93uzuGORGqcTOAy6u%252BlWXQ%3D%3D) | [Listing](https://www.digikey.com/en/products/detail/harwin-inc/M20-7832046/3728114) |
| Series input fuse | 0466001.NR | 1 | F1 | BreakoutBoard:Fuse_1206_3216Metric | [Listing](https://www.mouser.com/en/ProductDetail/Littelfuse/0466001.NR?qs=ar9f0rk5DXDy6tpNfF8WnQ%3D%3D) | [Listing](https://www.digikey.com/en/products/detail/littelfuse-inc/0466001-NR/521337) |
| Reverse-hookup MOSFET | AO3401A | 1 | Q1 | BreakoutBoard:SOT-23 | [Search only](https://www.mouser.com/c/?q=AO3401A) | [Listing](https://www.digikey.com/en/products/detail/alpha-omega-semiconductor-inc/AO3401A/1855943) |
| MOSFET gate-source clamp | BZT52C6V8-13-F | 1 | D2 | BreakoutBoard:D_SOD-123 | [Listing](https://www.mouser.com/en/ProductDetail/Diodes-Incorporated/BZT52C6V8-13-F?qs=VJbqQHImxExiLN1mVoOupA%3D%3D) | [Listing](https://www.digikey.com/en/products/detail/diodes-incorporated/BZT52C6V8-13-F/4570599) |
| Shared interrupt NAND | 74AHC30PW,118 | 1 | U4 | BreakoutBoard:TSSOP-14_4.4x5mm_P0.65mm | [Listing](https://www.mouser.com/ProductDetail/Nexperia/74AHC30PW118?qs=P62ublwmbi%252B963Q4ACANGA%3D%3D) | [Listing](https://www.digikey.com/en/products/detail/nexperia-usa-inc/74AHC30PW-118/3724158) |
| Chip-select bank OR gates | 74LVC32APW,118 | 2 | U1, U5 | BreakoutBoard:TSSOP-14_4.4x5mm_P0.65mm | [Listing](https://www.mouser.com/en/ProductDetail/Nexperia/74LVC32APW118?qs=me8TqzrmIYUPFZGtjJtRrA%3D%3D) | [Listing](https://www.digikey.com/en/products/detail/nexperia-usa-inc/74LVC32APW-118/946666) |
| Bank / shared-IRQ inverters | 74LVC04AT14-13 | 1 | U2 | BreakoutBoard:TSSOP-14_4.4x5mm_P0.65mm | [Listing](https://www.mouser.com/ProductDetail/Diodes-Incorporated/74LVC04AT14-13?qs=ZtY9WdtwX56ItyAjeD24GQ%3D%3D) | [Listing](https://www.digikey.com/en/products/detail/diodes-incorporated/74LVC04AT14-13/10452774) |
| Two-pin test header | M20-9990246 | 2 | TP13, TP14 | Connector_PinHeader_2.54mm:PinHeader_1x02_P2.54mm_Vertical | [Listing](https://www.mouser.com/en/ProductDetail/Harwin/M20-9990246?qs=Jph8NoUxIfWjw4WmyRvzag%3D%3D) | [Listing](https://www.digikey.com/en/products/detail/harwin-inc/M20-9990246/3728226) |

TP13 and TP14 use M20-9990246 two-pin 2.54 mm headers. F1 is present in the design. The 28 x 100 nF bypass capacitors use standard references C1 and C21-C47, with their exact MPN stored separately from the displayed value.

Bare test pads: TP1-TP12 and TP15-TP23, 21 total. Mounting holes: H1-H4. Neither group belongs in a purchase cart. Mating cable housings, contacts, cables, screws and standoffs are outside this fitted-PCB list.

The separate [order list](orderlist.md.txt) records order quantities, supplier stock, applicable USD prices and the dated sourcing limitations. No obsolete or unplaced design options are included.
