nischayhegde/jetson_spi_to_can_x8_breakout/review/resistor-substitution-2026-10-30/before/orderlist.md.txt

# PCB parts order list

**One board: 120 fitted components, 21 purchase lines. Order 129 pieces from DigiKey for a quoted parts subtotal of $37.36.** The 9 extra resistors reduce the order cost at the published quantity breaks. Every DigiKey line below showed stock sufficient for its order quantity in the retrieved listing.

Supplier snapshots retrieved **2026-10-29**. Web pages may be cached, so these are listing snapshots rather than a live reserved cart. USD prices exclude shipping, tax, tariffs and assembly. Use cut tape for SMD parts and bulk/tube for connectors. Do not select paid reeling. Mouser unit and line prices use the same order quantity for comparison; unverified stock is not treated as available.

| Manufacturer part | Needed | Order | DigiKey USD each | DigiKey USD line | DigiKey stock | DigiKey | Mouser USD each | Mouser stock | Mouser |
|---|---:|---:|---:|---:|---:|---|---:|---:|---|
| MCP251863T-E/SS | 8 | 8 | $2.3 | $18.40 | 1,218 | [Listing](https://www.digikey.com/en/products/detail/microchip-technology/MCP251863T-E-SS/15985723) | $2.3 | 6,897 | [Listing](https://www.mouser.com/en/ProductDetail/Microchip-Technology/MCP251863T-E-SS?qs=doiCPypUmgEjABEwFke1cA%3D%3D) |
| ABM8G-40.000MHZ-18-D2Y-T | 8 | 8 | $0.62 | $4.96 | 389 | [Listing](https://www.digikey.com/en/products/detail/abracon-llc/ABM8G-40-000MHZ-18-D2Y-T/2218027) | $0.62 | 1,362 | [Listing](https://www.mouser.com/en/ProductDetail/ABRACON/ABM8G-40.000MHZ-18-D2Y-T?qs=3LVMET7lfiO1sAQRIVmcWA%3D%3D) |
| TLV75533PDBVR | 1 | 1 | $0.45 | $0.45 | 82,294 | [Listing](https://www.digikey.com/en/products/detail/texas-instruments/TLV75533PDBVR/9356541) | $0.44 | 49,482 | [Listing](https://www.mouser.com/en/ProductDetail/Texas-Instruments/TLV75533PDBVR?qs=55YtniHzbhAKEwqeO2xJXQ%3D%3D) |
| CL10C270JB8NNNC | 16 | 16 | $0.028 | $0.45 | 1,471 | [Listing](https://www.digikey.com/en/products/detail/samsung-electro-mechanics/CL10C270JB8NNNC/3889172) | n.a. | Unverified | [Listing](https://www.mouser.it/ProductDetail/Samsung-Electro-Mechanics/CL10C270JB8NNNC?qs=349EhDEZ59qQ7Bw6gEHQYQ%3D%3D) |
| CC0603KRX7R9BB104 | 28 | 28 | $0.08 | $2.24 | 62,814 | [Listing](https://www.digikey.com/en/products/detail/yageo/CC0603KRX7R9BB104/2103082) | $0.073 | 47,009,219 | [Listing](https://www.mouser.com/en/ProductDetail/YAGEO/CC0603KRX7R9BB104?qs=vTakOoo5QyLvVCYM2ge8LQ%3D%3D) |
| CGA3E1X7R1E105K080AC | 2 | 2 | $0.17 | $0.34 | 1,368,662 | [Listing](https://www.digikey.com/en/products/detail/tdk/CGA3E1X7R1E105K080AC/2672949) | $0.17 | 1,426,652 | [Listing](https://www.mouser.com/en/ProductDetail/TDK/CGA3E1X7R1E105K080AC?qs=NRhsANhppD9VxGl2AsmRpw%3D%3D) |
| CL21B106KOQNNNE | 1 | 1 | $0.27 | $0.27 | 187,206 | [Listing](https://www.digikey.com/en/products/detail/samsung-electro-mechanics/CL21B106KOQNNNE/3888530) | $0.3 | Unverified | [Listing](https://www.mouser.com/en/ProductDetail/Samsung-Electro-Mechanics/CL21B106KOQNNNE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) |
| RC1206FR-07120RL | 8 | 10 | $0.047 | $0.47 | 131,576 | [Listing](https://www.digikey.com/en/products/detail/yageo/RC1206FR-07120RL/728523) | $0.025 | 120,281 | [Listing](https://www.mouser.com/en/ProductDetail/YAGEO/RC1206FR-07120RL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) |
| RC0603FR-0710KL | 9 | 10 | $0.025 | $0.25 | 2,396,093 | [Listing](https://www.digikey.com/en/products/detail/yageo/RC0603FR-0710KL/726880) | $0.014 | 2,782,034 | [Listing](https://www.mouser.com/en/ProductDetail/603-RC0603FR-0710KL) |
| RC0603FR-07100KL | 4 | 10 | $0.025 | $0.25 | 2,081,432 | [Listing](https://www.digikey.com/en/products/detail/yageo/RC0603FR-07100KL/726889) | $0.014 | 4,585,377 | [Listing](https://www.mouser.com/en/ProductDetail/YAGEO/RC0603FR-07100KL?qs=e1ok2LiJcmaihem8Va5%2Fsw%3D%3D) |
| RC0603FR-0733RL | 16 | 16 | $0.025 | $0.40 | 1,088,640 | [Listing](https://www.digikey.com/en/products/detail/yageo/RC0603FR-0733RL/730105) | $0.014 | 595,649 | [Listing](https://www.mouser.com/en/ProductDetail/YAGEO/RC0603FR-0733RL?qs=diQw95jMAeMotgif2GSHTQ%3D%3D) |
| B3B-XH-A | 8 | 8 | $0.13 | $1.04 | 120,351 | [Listing](https://www.digikey.com/en/products/detail/jst-sales-america-inc/B3B-XH-A/1651046) | $0.13 | Unverified | [Listing](https://www.mouser.com/en/ProductDetail/JST-Commercial/B3B-XH-ALFSN?qs=cdbOS8ANM9BVkoboCCIEMQ%3D%3D) |
| B2B-XH-A | 1 | 1 | $0.1 | $0.10 | 320,857 | [Listing](https://www.digikey.com/en/products/detail/jst-sales-america-inc/B2B-XH-A/1651045) | $0.1 | 560 | [Listing](https://www.mouser.com/en/ProductDetail/JST-Commercial/B2B-XH-ALFSN?qs=cdbOS8ANM9DdcSn9qRmfCw%3D%3D) |
| M20-7832046 | 1 | 1 | $4.34 | $4.34 | 4,597 | [Listing](https://www.digikey.com/en/products/detail/harwin-inc/M20-7832046/3728114) | $4.13 | 1,973 | [Listing](https://www.mouser.com/en/ProductDetail/Harwin/M20-7832046?qs=93uzuGORGqcTOAy6u%252BlWXQ%3D%3D) |
| 0466001.NR | 1 | 1 | $1.25 | $1.25 | 36,548 | [Listing](https://www.digikey.com/en/products/detail/littelfuse-inc/0466001-NR/521337) | $0.78 | 45,577 | [Listing](https://www.mouser.com/en/ProductDetail/Littelfuse/0466001.NR?qs=ar9f0rk5DXDy6tpNfF8WnQ%3D%3D) |
| AO3401A | 1 | 1 | $0.52 | $0.52 | 443,245 | [Listing](https://www.digikey.com/en/products/detail/alpha-omega-semiconductor-inc/AO3401A/1855943) | n.a. | Unverified | [Search only](https://www.mouser.com/c/?q=AO3401A) |
| BZT52C6V8-13-F | 1 | 1 | $0.22 | $0.22 | 6,702 | [Listing](https://www.digikey.com/en/products/detail/diodes-incorporated/BZT52C6V8-13-F/4570599) | $0.21 | 9,830 | [Listing](https://www.mouser.com/en/ProductDetail/Diodes-Incorporated/BZT52C6V8-13-F?qs=VJbqQHImxExiLN1mVoOupA%3D%3D) |
| 74AHC30PW,118 | 1 | 1 | $0.39 | $0.39 | 6,890 | [Listing](https://www.digikey.com/en/products/detail/nexperia-usa-inc/74AHC30PW-118/3724158) | $0.39 | 3,795 | [Listing](https://www.mouser.com/ProductDetail/Nexperia/74AHC30PW118?qs=P62ublwmbi%252B963Q4ACANGA%3D%3D) |
| 74LVC32APW,118 | 2 | 2 | $0.25 | $0.50 | 6,192 | [Listing](https://www.digikey.com/en/products/detail/nexperia-usa-inc/74LVC32APW-118/946666) | $0.25 | 3,867 | [Listing](https://www.mouser.com/en/ProductDetail/Nexperia/74LVC32APW118?qs=me8TqzrmIYUPFZGtjJtRrA%3D%3D) |
| 74LVC04AT14-13 | 1 | 1 | $0.32 | $0.32 | 4,004 | [Listing](https://www.digikey.com/en/products/detail/diodes-incorporated/74LVC04AT14-13/10452774) | $0.28 | 2,760 | [Listing](https://www.mouser.com/ProductDetail/Diodes-Incorporated/74LVC04AT14-13?qs=ZtY9WdtwX56ItyAjeD24GQ%3D%3D) |
| M20-9990246 | 2 | 2 | $0.1 | $0.20 | 179,951 | [Listing](https://www.digikey.com/en/products/detail/harwin-inc/M20-9990246/3728226) | $0.1 | 98,136 | [Listing](https://www.mouser.com/en/ProductDetail/Harwin/M20-9990246?qs=Jph8NoUxIfWjw4WmyRvzag%3D%3D) |
| **Total** | **120** | **129** | | **$37.36** | | | | | |

Order ten RC1206FR-07120RL for eight fitted positions, ten RC0603FR-0710KL for nine fitted positions, and ten RC0603FR-07100KL for four fitted positions. All other order quantities equal the fitted quantity. No discretionary spare ICs or connectors are added.

**Footprint matching:** R6/R10/R13/R16/R23/R26/R29/R32 all use the same 1206 termination footprint and MPN. J1 consistently specifies the female M20-7832046 socket. TP13/TP14 specify M20-9990246 two-pin headers. MPN and Manufacturer fields in the schematic and PCB drive this list. The standardization changed R26's package and local bottom routing, corrected metadata and capacitor references, and retained every circuit connection.

**Mouser exceptions:** AO3401A has a clearly labeled search link because an exact Alpha & Omega product listing was not verified. The Samsung 27 pF capacitor has an exact regional listing, but its stock and USD price were not verified. C20 and the white three-pin JST connector also lack verified current Mouser stock. The DigiKey entries retain the standardized CAD's specified MPNs.

| Supplier observation | Source and detail |
|---|---|
| CL10C270JB8NNNC | [Source](https://www.mouser.it/ProductDetail/Samsung-Electro-Mechanics/CL10C270JB8NNNC?qs=349EhDEZ59qQ7Bw6gEHQYQ%3D%3D). Exact listing found; stock and USD price not verified. Buy the specified Samsung part from DigiKey. |
| CGA3E1X7R1E105K080AC | [Source](https://www.mouser.com/en/c/passive-components/capacitors/ceramic-capacitors/mlccs-multilayer-ceramic-capacitors/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). Stock and USD pricing from Mouser US category listing. |
| CL21B106KOQNNNE | [Source](https://www.mouser.co.il/en/ProductDetail/Samsung-Electro-Mechanics/CL21B106KOQNNNE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). Exact E suffix. USD price from Mouser Israel; current stock not verified. Do not replace with the G suffix automatically. |
| RC1206FR-07120RL | [Source](https://www.mouser.com/en/c/passive-components/resistors/smd-resistors-chip-resistors/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). US stock and pricing from exact MPN row in Mouser category results. |
| RC0603FR-07100KL | [Source](https://www.mouser.com/en/c/passive-components/resistors/smd-resistors-chip-resistors/thick-film-resistors/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). US stock and pricing from exact MPN row in Mouser category results. |
| B3B-XH-A | [Source](https://www.mouser.com/en/ProductDetail/JST-Commercial/B3B-XH-ALFSN?qs=cdbOS8ANM9BVkoboCCIEMQ%3D%3D). Listing uses B3B-XH-A(LF)(SN). Stock not verified. No black, reverse, or press-fit variants selected. |
| B2B-XH-A | [Source](https://www.mouser.co.za/en/ProductDetail/JST-Commercial/B2B-XH-ALFSN?qs=cdbOS8ANM9DdcSn9qRmfCw%3D%3D). Listing uses B2B-XH-A(LF)(SN). Stock evidence from Mouser South Africa. No A-M/press-fit variant selected. |
| AO3401A | [Source](https://www.mouser.com/c/?q=AO3401A). Search link only: no exact AOS AO3401A Mouser product listing verified. No MOSFET substitution selected. |
| M20-9990246 | [Source](https://www.mouser.co.il/en/ProductDetail/Harwin/M20-9990246?qs=sGAEpiMZZMvlX3nhDDO4AAIUUFD6r3d5GOgk8mOB0I8%3D). Stock from Mouser Israel exact listing; USD unit price from US listing. |

Exact references, complete footprint names and supplier SKUs are in [the CSV](orderlist.csv) and [the workbook](orderlist.xlsx). The fitted-only BOM is in [componentlist](componentlist.md.txt).
