nischayhegde/jetson_spi_to_can_x8_breakout/componentlist.csv

mpn | cad_mpn | manufacturer | quantity | schematic_quantity | board_quantity | placed_references | design_value | footprint | function | specifications | status | mouser_url | digikey_url | notes
MCP251863T-E/SS | MCP251863T-E/SS | Microchip | 8 | 8 | 8 | U9;U10;U11;U12;U13;U14;U15;U16 | MCP251863T-E/SS | BreakoutBoard:SSOP-28_5.3x10.2mm_P0.65mm | CAN controller/transceiver | SPI CAN FD controller plus transceiver; SSOP-28; VDD/VIO=3.3 V, VCC=5 V | PLACED | https://www.mouser.com/en/ProductDetail/Microchip-Technology/MCP251863T-E-SS?qs=doiCPypUmgEjABEwFke1cA%3D%3D | https://www.digikey.com/en/products/detail/microchip-technology/MCP251863T-E-SS/15985723 | 8 fitted; 1 spare(s).
ABM8G-40.000MHZ-18-D2Y-T | ABM8G-40.000MHZ-18-D2Y-T | Abracon | 8 | 8 | 8 | Y1;Y2;Y3;Y4;Y5;Y6;Y7;Y8 | ABM8G-40.000MHZ-18-D2Y-T | BreakoutBoard:Crystal_SMD_Abracon_ABM8G-4Pin_3.2x2.5mm | 40 MHz crystal | Passive crystal; CL=18 pF; grounded case pads; 3.2 x 2.5 mm | PLACED | https://www.mouser.com/en/ProductDetail/ABRACON/ABM8G-40.000MHZ-18-D2Y-T?qs=3LVMET7lfiO1sAQRIVmcWA%3D%3D | https://www.digikey.com/en/products/detail/abracon-llc/ABM8G-40-000MHZ-18-D2Y-T/2218027 | 8 fitted; 1 spare(s).
TLV75533PDBVR | TLV75533PDBVR | Texas Instruments | 1 | 1 | 1 | U3 | TLV75533PDBVR | BreakoutBoard:SOT-23-5 | 3.3 V LDO | Fixed 3.3 V, 500 mA; SOT-23-5 / DBV | PLACED | https://www.mouser.com/en/ProductDetail/Texas-Instruments/TLV75533PDBVR?qs=55YtniHzbhAKEwqeO2xJXQ%3D%3D | https://www.digikey.com/en/products/detail/texas-instruments/TLV75533PDBVR/9356541 | 1 fitted; 1 spare(s).
CL10C270JB8NNNC | CL10C270JB8NNNC | Samsung Electro-Mechanics | 16 | 16 | 16 | C2;C3;C4;C5;C6;C7;C8;C9;C10;C11;C12;C13;C14;C15;C16;C17 | 27p | Capacitor_SMD:C_0603_1608Metric | Crystal load capacitor | 27 pF, +/-5%, C0G/NP0, 50 V, 0603 | PLACED | https://www.mouser.it/ProductDetail/Samsung-Electro-Mechanics/CL10C270JB8NNNC?qs=349EhDEZ59qQ7Bw6gEHQYQ%3D%3D | https://www.digikey.com/en/products/detail/samsung-electro-mechanics/CL10C270JB8NNNC/3889172 | 16 fitted; 2 spare(s).
CC0603KRX7R9BB104 | CC0603KRX7R9BB104 | YAGEO | 28 | 28 | 28 | C1;C21;C22;C23;C24;C25;C26;C27;C28;C29;C30;C31;C32;C33;C34;C35;C36;C37;C38;C39;C40;C41;C42;C43;C44;C45;C46;C47 | 100n | BreakoutBoard:C_0603_1608Metric | Local bypass capacitor | 100 nF, +/-10%, X7R, 50 V, 0603 | PLACED | https://www.mouser.com/en/ProductDetail/YAGEO/CC0603KRX7R9BB104?qs=vTakOoo5QyLvVCYM2ge8LQ%3D%3D | https://www.digikey.com/en/products/detail/yageo/CC0603KRX7R9BB104/2103082 | 28 x 100 nF bypass capacitors: C1 and C21-C47. MPN retained in hidden fields. 28 fitted; 2 spare(s).
CGA3E1X7R1E105K080AC | CGA3E1X7R1E105K080AC | TDK | 2 | 2 | 2 | C18;C19 | 1u | BreakoutBoard:C_0603_1608Metric | LDO input/output capacitor | 1 uF, +/-10%, X7R, 25 V, 0603 | PLACED | https://www.mouser.com/en/ProductDetail/TDK/CGA3E1X7R1E105K080AC?qs=NRhsANhppD9VxGl2AsmRpw%3D%3D | https://www.digikey.com/en/products/detail/tdk/CGA3E1X7R1E105K080AC/2672949 | 2 fitted; 1 spare(s).
CL21B106KOQNNNE | CL21B106KOQNNNE | Samsung Electro-Mechanics | 1 | 1 | 1 | C20 | 10u | BreakoutBoard:C_0805_2012Metric | Protected-input bulk capacitor | 10 uF, +/-10%, X7R, 16 V, 0805 | PLACED | https://www.mouser.com/en/ProductDetail/Samsung-Electro-Mechanics/CL21B106KOQNNNE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 | https://www.digikey.com/en/products/detail/samsung-electro-mechanics/CL21B106KOQNNNE/3888530 | 1 fitted; 1 spare(s).
RC1206FR-07120RL | RC1206FR-07120RL | YAGEO | 8 | 8 | 8 | R6;R10;R13;R16;R23;R26;R29;R32 | 120 | BreakoutBoard:R_1206_3216Metric | Fixed CAN termination | 120 ohm, +/-1%, 0.25 W, 1206 | PLACED | https://www.mouser.com/en/ProductDetail/YAGEO/RC1206FR-07120RL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 | https://www.digikey.com/en/products/detail/yageo/RC1206FR-07120RL/728523 | All eight CAN termination resistors use this 1206, 120-ohm, 1%, 0.25 W part. 8 fitted; 1 spare(s).
AC0603FR-0710KL | RC0603FR-0710KL | YAGEO | 9 | 9 | 9 | R7;R8;R11;R14;R17;R24;R27;R30;R38 | 10k | BreakoutBoard:R_0603_1608Metric | CAN nCS pull-ups / MOSFET gate pull-down | 10 kohm, +/-1%, 0.1 W, 0603 (1608 metric), +/-100 ppm/C, AEC-Q200 | APPROVED SUBSTITUTE | https://my.mouser.com/ProductDetail/YAGEO/AC0603FR-0710KL?qs=UoPT7wUmgYKz3zh0UDMA4Q%3D%3D | https://www.digikey.com/en/products/detail/yageo/AC0603FR-0710KL/2828135 | CAD MPN: RC0603FR-0710KL. Original RC0603FR-0710KL is out of stock at DigiKey. AC0603FR-0710KL matches its resistance, tolerance, power, TCR and 1.60 x 0.80 x 0.45 mm nominal body. Purchase this compatible substitute for the existing 0603 footprint; no CAD or Gerber changes. 9 fitted; 1 spare(s).
CRCW0603100KFKEA | RC0603FR-07100KL | Vishay Dale | 4 | 4 | 4 | R34;R35;R36;R37 | 100k | BreakoutBoard:R_0603_1608Metric | Native Jetson CS pull-ups | 100 kohm, +/-1%, 0.1 W standard rating, 0603 (1608 metric), +/-100 ppm/C, AEC-Q200 | APPROVED SUBSTITUTE | https://www.mouser.com/en/ProductDetail/Vishay/CRCW0603100KFKEA?qs=6dqgS%252BKntICWHMMdIzt5%2FQ%3D%3D | https://www.digikey.com/en/products/detail/vishay-dale/CRCW0603100KFKEA/1174896 | CAD MPN: RC0603FR-07100KL. Original RC0603FR-07100KL is on backorder at DigiKey. CRCW0603100KFKEA matches 100 kohm, 1%, at least 0.1 W and 100 ppm/C. Its standard 0603 body (nominal 1.55 x 0.85 x 0.45 mm) fits the existing IPC-7351 nominal R_0603_1608Metric footprint. The manufacturer specifies 0.10 W standard / 0.125 W extended operation. No schematic, PCB or Gerber change is required. 4 fitted; 1 spare(s).
RC0603FR-0733RL | RC0603FR-0733RL | YAGEO | 16 | 16 | 16 | R1;R2;R3;R4;R5;R9;R12;R15;R18;R19;R20;R21;R22;R25;R28;R31 | 33 | BreakoutBoard:R_0603_1608Metric | SPI series damping | 33 ohm, +/-1%, 0.1 W, 0603 | PLACED | https://www.mouser.com/en/ProductDetail/YAGEO/RC0603FR-0733RL?qs=diQw95jMAeMotgif2GSHTQ%3D%3D | https://www.digikey.com/en/products/detail/yageo/RC0603FR-0733RL/730105 | 16 fitted; 2 spare(s).
B3B-XH-A | B3B-XH-A | JST | 8 | 8 | 8 | J4;J5;J7;J8;J9;J10;J11;J12 | B3B-XH-A | BreakoutBoard:JST_XH_B3B-XH-A_1x03_P2.50mm_Vertical | CAN connector | 3 positions, 2.50 mm pitch, vertical through-hole XH header | PLACED | https://www.mouser.com/en/ProductDetail/JST-Commercial/B3B-XH-ALFSN?qs=cdbOS8ANM9BVkoboCCIEMQ%3D%3D | https://www.digikey.com/en/products/detail/jst-sales-america-inc/B3B-XH-A/1651046 | 8 fitted; 1 spare(s).
B2B-XH-A | B2B-XH-A | JST | 1 | 1 | 1 | J6 | B2B-XH-A | BreakoutBoard:JST_XH_B2B-XH-A_1x02_P2.50mm_Vertical | 5 V input connector | 2 positions, 2.50 mm pitch, vertical through-hole XH header | PLACED | https://www.mouser.com/en/ProductDetail/JST-Commercial/B2B-XH-ALFSN?qs=cdbOS8ANM9DdcSn9qRmfCw%3D%3D | https://www.digikey.com/en/products/detail/jst-sales-america-inc/B2B-XH-A/1651045 | 1 fitted; 1 spare(s).
M20-7832046 | M20-7832046 | Harwin | 1 | 1 | 1 | J1 | M20-7832046 | Connector_PinSocket_2.54mm:PinSocket_2x20_P2.54mm_Vertical | Jetson 40-pin female socket | Female 2 x 20, 2.54 mm pitch, vertical through-hole; 8.5 mm above PCB; tin contacts | PLACED | https://www.mouser.com/en/ProductDetail/Harwin/M20-7832046?qs=93uzuGORGqcTOAy6u%252BlWXQ%3D%3D | https://www.digikey.com/en/products/detail/harwin-inc/M20-7832046/3728114 | J1 consistently uses M20-7832046 and the female socket footprint in the schematic, PCB and order list. 1 fitted; 1 spare(s).
0466001.NR | 0466001.NR | Littelfuse | 1 | 1 | 1 | F1 | 0466001.NR | BreakoutBoard:Fuse_1206_3216Metric | Series input fuse | 1 A, 63 V AC/DC, fast acting, 1206 | PLACED | https://www.mouser.com/en/ProductDetail/Littelfuse/0466001.NR?qs=ar9f0rk5DXDy6tpNfF8WnQ%3D%3D | https://www.digikey.com/en/products/detail/littelfuse-inc/0466001-NR/521337 | F1 is fitted in the current schematic and layout. 1 fitted; 1 spare(s).
AO3401A | AO3401A | Alpha & Omega Semiconductor | 1 | 1 | 1 | Q1 | AO3401A | BreakoutBoard:SOT-23 | Reverse-hookup MOSFET | P-channel, -30 V, VGS absolute maximum +/-12 V, SOT-23 | PLACED | https://www.mouser.com/c/?q=AO3401A | https://www.digikey.com/en/products/detail/alpha-omega-semiconductor-inc/AO3401A/1855943 | Keep Alpha & Omega AO3401A. No alternate MOSFET selected. 1 fitted; 1 spare(s).
BZT52C6V8-13-F | BZT52C6V8-13-F | Diodes Incorporated | 1 | 1 | 1 | D2 | BZT52C6V8-13-F | BreakoutBoard:D_SOD-123 | MOSFET gate-source clamp | 6.8 V Zener, SOD-123; not a 5 V rail clamp | PLACED | https://www.mouser.com/en/ProductDetail/Diodes-Incorporated/BZT52C6V8-13-F?qs=VJbqQHImxExiLN1mVoOupA%3D%3D | https://www.digikey.com/en/products/detail/diodes-incorporated/BZT52C6V8-13-F/4570599 | 1 fitted; 1 spare(s).
74AHC30PW,118 | 74AHC30PW,118 | Nexperia | 1 | 1 | 1 | U4 | 74AHC30PW,118 | BreakoutBoard:TSSOP-14_4.4x5mm_P0.65mm | Shared interrupt NAND | 8-input NAND, TSSOP-14; powered at 3.3 V | PLACED | https://www.mouser.com/ProductDetail/Nexperia/74AHC30PW118?qs=P62ublwmbi%252B963Q4ACANGA%3D%3D | https://www.digikey.com/en/products/detail/nexperia-usa-inc/74AHC30PW-118/3724158 | 1 fitted; 1 spare(s).
74LVC32APW,118 | 74LVC32APW,118 | Nexperia | 2 | 2 | 2 | U1;U5 | 74LVC32APW,118 | BreakoutBoard:TSSOP-14_4.4x5mm_P0.65mm | Chip-select bank OR gates | Quad 2-input OR, TSSOP-14; powered at 3.3 V | PLACED | https://www.mouser.com/en/ProductDetail/Nexperia/74LVC32APW118?qs=me8TqzrmIYUPFZGtjJtRrA%3D%3D | https://www.digikey.com/en/products/detail/nexperia-usa-inc/74LVC32APW-118/946666 | 2 fitted; 1 spare(s).
74LVC04AT14-13 | 74LVC04AT14-13 | Diodes Incorporated | 1 | 1 | 1 | U2 | 74LVC04AT14-13 | BreakoutBoard:TSSOP-14_4.4x5mm_P0.65mm | Bank / shared-IRQ inverters | Hex NOT, TSSOP-14; powered at 3.3 V | PLACED | https://www.mouser.com/ProductDetail/Diodes-Incorporated/74LVC04AT14-13?qs=ZtY9WdtwX56ItyAjeD24GQ%3D%3D | https://www.digikey.com/en/products/detail/diodes-incorporated/74LVC04AT14-13/10452774 | 1 fitted; 1 spare(s).
M20-9990246 | M20-9990246 | Harwin | 2 | 2 | 2 | TP13;TP14 | M20-9990246 | Connector_PinHeader_2.54mm:PinHeader_1x02_P2.54mm_Vertical | Two-pin test header | Male 1 x 2, 2.54 mm pitch, vertical through-hole; 0.64 mm square pins; 3 mm solder tails | PLACED | https://www.mouser.com/en/ProductDetail/Harwin/M20-9990246?qs=Jph8NoUxIfWjw4WmyRvzag%3D%3D | https://www.digikey.com/en/products/detail/harwin-inc/M20-9990246/3728226 | Fitted headers for TP13 and TP14. The other 21 test points are bare PCB pads. 2 fitted; 1 spare(s).
