nischayhegde/jetson_spi_to_can_x8_breakout/orderlist.xlsx

PCB parts for one board
120 fitted components. Order 144 pieces across 21 purchase lines.
Stock/prices: 2026-10-29; 10k/100k replacements checked 2026-10-30. USD excludes shipping, tax and tariffs.
Manufacturer part | Needed | Order | DigiKey USD each | DigiKey USD line | DigiKey stock | Mouser USD each | Mouser USD line | Mouser stock | DigiKey | Mouser | References | Existing PCB footprint | Notes
MCP251863T-E/SS | 8 | 9 | $2.3000 | $20.70 | 1218 | $2.3000 | $20.70 | 6897 | DigiKey (https://www.digikey.com/en/products/detail/microchip-technology/MCP251863T-E-SS/15985723) | Mouser (https://www.mouser.com/en/ProductDetail/Microchip-Technology/MCP251863T-E-SS?qs=doiCPypUmgEjABEwFke1cA%3D%3D) | U9, U10, U11, U12, U13, U14, U15, U16 | BreakoutBoard:SSOP-28_5.3x10.2mm_P0.65mm | 8 fitted; 1 spare(s).
ABM8G-40.000MHZ-18-D2Y-T | 8 | 9 | $0.6200 | $5.58 | 389 | $0.6200 | $5.58 | 1362 | DigiKey (https://www.digikey.com/en/products/detail/abracon-llc/ABM8G-40-000MHZ-18-D2Y-T/2218027) | Mouser (https://www.mouser.com/en/ProductDetail/ABRACON/ABM8G-40.000MHZ-18-D2Y-T?qs=3LVMET7lfiO1sAQRIVmcWA%3D%3D) | Y1, Y2, Y3, Y4, Y5, Y6, Y7, Y8 | BreakoutBoard:Crystal_SMD_Abracon_ABM8G-4Pin_3.2x2.5mm | 8 fitted; 1 spare(s).
TLV75533PDBVR | 1 | 2 | $0.4500 | $0.90 | 82294 | $0.4400 | $0.88 | 49482 | DigiKey (https://www.digikey.com/en/products/detail/texas-instruments/TLV75533PDBVR/9356541) | Mouser (https://www.mouser.com/en/ProductDetail/Texas-Instruments/TLV75533PDBVR?qs=55YtniHzbhAKEwqeO2xJXQ%3D%3D) | U3 | BreakoutBoard:SOT-23-5 | 1 fitted; 1 spare(s).
CL10C270JB8NNNC | 16 | 18 | $0.0280 | $0.50 | 1471 | n.a. | n.a. | Unverified | DigiKey (https://www.digikey.com/en/products/detail/samsung-electro-mechanics/CL10C270JB8NNNC/3889172) | Mouser (https://www.mouser.it/ProductDetail/Samsung-Electro-Mechanics/CL10C270JB8NNNC?qs=349EhDEZ59qQ7Bw6gEHQYQ%3D%3D) | C2, C3, C4, C5, C6, C7, C8, C9, C10, C11, C12, C13, C14, C15, C16, C17 | Capacitor_SMD:C_0603_1608Metric | 16 fitted; 2 spare(s).
CC0603KRX7R9BB104 | 28 | 30 | $0.0800 | $2.40 | 62814 | $0.0730 | $2.19 | 47009219 | DigiKey (https://www.digikey.com/en/products/detail/yageo/CC0603KRX7R9BB104/2103082) | Mouser (https://www.mouser.com/en/ProductDetail/YAGEO/CC0603KRX7R9BB104?qs=vTakOoo5QyLvVCYM2ge8LQ%3D%3D) | C1, C21-C47 | BreakoutBoard:C_0603_1608Metric | 28 x 100 nF bypass capacitors: C1 and C21-C47. MPN retained in hidden fields. 28 fitted; 2 spare(s).
CGA3E1X7R1E105K080AC | 2 | 3 | $0.1700 | $0.51 | 1368662 | $0.1700 | $0.51 | 1426652 | DigiKey (https://www.digikey.com/en/products/detail/tdk/CGA3E1X7R1E105K080AC/2672949) | Mouser (https://www.mouser.com/en/ProductDetail/TDK/CGA3E1X7R1E105K080AC?qs=NRhsANhppD9VxGl2AsmRpw%3D%3D) | C18, C19 | BreakoutBoard:C_0603_1608Metric | 2 fitted; 1 spare(s).
CL21B106KOQNNNE | 1 | 2 | $0.2700 | $0.54 | 187206 | $0.3000 | $0.60 | Unverified | DigiKey (https://www.digikey.com/en/products/detail/samsung-electro-mechanics/CL21B106KOQNNNE/3888530) | Mouser (https://www.mouser.com/en/ProductDetail/Samsung-Electro-Mechanics/CL21B106KOQNNNE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) | C20 | BreakoutBoard:C_0805_2012Metric | 1 fitted; 1 spare(s).
RC1206FR-07120RL | 8 | 9 | $0.1000 | $0.90 | 131576 | $0.1000 | $0.90 | 120281 | DigiKey (https://www.digikey.com/en/products/detail/yageo/RC1206FR-07120RL/728523) | Mouser (https://www.mouser.com/en/ProductDetail/YAGEO/RC1206FR-07120RL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) | R6, R10, R13, R16, R23, R26, R29, R32 | BreakoutBoard:R_1206_3216Metric | All eight CAN termination resistors use this 1206, 120-ohm, 1%, 0.25 W part. 8 fitted; 1 spare(s).
AC0603FR-0710KL | 9 | 10 | $0.0300 | $0.30 | 971121 | n.a. | n.a. | Unverified | DigiKey (https://www.digikey.com/en/products/detail/yageo/AC0603FR-0710KL/2828135) | Mouser (https://my.mouser.com/ProductDetail/YAGEO/AC0603FR-0710KL?qs=UoPT7wUmgYKz3zh0UDMA4Q%3D%3D) | R7, R8, R11, R14, R17, R24, R27, R30, R38 | BreakoutBoard:R_0603_1608Metric | CAD MPN: RC0603FR-0710KL. Original RC0603FR-0710KL is out of stock at DigiKey. AC0603FR-0710KL matches its resistance, tolerance, power, TCR and 1.60 x 0.80 x 0.45 mm nominal body. Purchase this compatible substitute for the existing 0603 footprint; no CAD or Gerber changes. 9 fitted; 1 spare(s).
CRCW0603100KFKEA | 4 | 5 | $0.1000 | $0.50 | 3055789 | n.a. | n.a. | Unverified | DigiKey (https://www.digikey.com/en/products/detail/vishay-dale/CRCW0603100KFKEA/1174896) | Mouser (https://www.mouser.com/en/ProductDetail/Vishay/CRCW0603100KFKEA?qs=6dqgS%252BKntICWHMMdIzt5%2FQ%3D%3D) | R34, R35, R36, R37 | BreakoutBoard:R_0603_1608Metric | CAD MPN: RC0603FR-07100KL. Original RC0603FR-07100KL is on backorder at DigiKey. CRCW0603100KFKEA matches 100 kohm, 1%, at least 0.1 W and 100 ppm/C. Its standard 0603 body (nominal 1.55 x 0.85 x 0.45 mm) fits the existing IPC-7351 nominal R_0603_1608Metric footprint. The manufacturer specifies 0.10 W standard / 0.125 W extended operation. No schematic, PCB or Gerber change is required. 4 fitted; 1 spare(s).
RC0603FR-0733RL | 16 | 18 | $0.0250 | $0.45 | 1088640 | $0.0140 | $0.25 | 595649 | DigiKey (https://www.digikey.com/en/products/detail/yageo/RC0603FR-0733RL/730105) | Mouser (https://www.mouser.com/en/ProductDetail/YAGEO/RC0603FR-0733RL?qs=diQw95jMAeMotgif2GSHTQ%3D%3D) | R1, R2, R3, R4, R5, R9, R12, R15, R18, R19, R20, R21, R22, R25, R28, R31 | BreakoutBoard:R_0603_1608Metric | 16 fitted; 2 spare(s).
B3B-XH-A | 8 | 9 | $0.1300 | $1.17 | 120351 | $0.1300 | $1.17 | Unverified | DigiKey (https://www.digikey.com/en/products/detail/jst-sales-america-inc/B3B-XH-A/1651046) | Mouser (https://www.mouser.com/en/ProductDetail/JST-Commercial/B3B-XH-ALFSN?qs=cdbOS8ANM9BVkoboCCIEMQ%3D%3D) | J4, J5, J7, J8, J9, J10, J11, J12 | BreakoutBoard:JST_XH_B3B-XH-A_1x03_P2.50mm_Vertical | 8 fitted; 1 spare(s).
B2B-XH-A | 1 | 2 | $0.1000 | $0.20 | 320857 | $0.1000 | $0.20 | 560 | DigiKey (https://www.digikey.com/en/products/detail/jst-sales-america-inc/B2B-XH-A/1651045) | Mouser (https://www.mouser.com/en/ProductDetail/JST-Commercial/B2B-XH-ALFSN?qs=cdbOS8ANM9DdcSn9qRmfCw%3D%3D) | J6 | BreakoutBoard:JST_XH_B2B-XH-A_1x02_P2.50mm_Vertical | 1 fitted; 1 spare(s).
M20-7832046 | 1 | 2 | $4.3400 | $8.68 | 4597 | $4.1300 | $8.26 | 1973 | DigiKey (https://www.digikey.com/en/products/detail/harwin-inc/M20-7832046/3728114) | Mouser (https://www.mouser.com/en/ProductDetail/Harwin/M20-7832046?qs=93uzuGORGqcTOAy6u%252BlWXQ%3D%3D) | J1 | Connector_PinSocket_2.54mm:PinSocket_2x20_P2.54mm_Vertical | J1 consistently uses M20-7832046 and the female socket footprint in the schematic, PCB and order list. 1 fitted; 1 spare(s).
0466001.NR | 1 | 2 | $1.2500 | $2.50 | 36548 | $0.7800 | $1.56 | 45577 | DigiKey (https://www.digikey.com/en/products/detail/littelfuse-inc/0466001-NR/521337) | Mouser (https://www.mouser.com/en/ProductDetail/Littelfuse/0466001.NR?qs=ar9f0rk5DXDy6tpNfF8WnQ%3D%3D) | F1 | BreakoutBoard:Fuse_1206_3216Metric | F1 is fitted in the current schematic and layout. 1 fitted; 1 spare(s).
AO3401A | 1 | 2 | $0.5200 | $1.04 | 443245 | n.a. | n.a. | Unverified | DigiKey (https://www.digikey.com/en/products/detail/alpha-omega-semiconductor-inc/AO3401A/1855943) | Search only (https://www.mouser.com/c/?q=AO3401A) | Q1 | BreakoutBoard:SOT-23 | Keep Alpha & Omega AO3401A. No alternate MOSFET selected. 1 fitted; 1 spare(s).
BZT52C6V8-13-F | 1 | 2 | $0.2200 | $0.44 | 6702 | $0.2100 | $0.42 | 9830 | DigiKey (https://www.digikey.com/en/products/detail/diodes-incorporated/BZT52C6V8-13-F/4570599) | Mouser (https://www.mouser.com/en/ProductDetail/Diodes-Incorporated/BZT52C6V8-13-F?qs=VJbqQHImxExiLN1mVoOupA%3D%3D) | D2 | BreakoutBoard:D_SOD-123 | 1 fitted; 1 spare(s).
74AHC30PW,118 | 1 | 2 | $0.3900 | $0.78 | 6890 | $0.3900 | $0.78 | 3795 | DigiKey (https://www.digikey.com/en/products/detail/nexperia-usa-inc/74AHC30PW-118/3724158) | Mouser (https://www.mouser.com/ProductDetail/Nexperia/74AHC30PW118?qs=P62ublwmbi%252B963Q4ACANGA%3D%3D) | U4 | BreakoutBoard:TSSOP-14_4.4x5mm_P0.65mm | 1 fitted; 1 spare(s).
74LVC32APW,118 | 2 | 3 | $0.2500 | $0.75 | 6192 | $0.2500 | $0.75 | 3867 | DigiKey (https://www.digikey.com/en/products/detail/nexperia-usa-inc/74LVC32APW-118/946666) | Mouser (https://www.mouser.com/en/ProductDetail/Nexperia/74LVC32APW118?qs=me8TqzrmIYUPFZGtjJtRrA%3D%3D) | U1, U5 | BreakoutBoard:TSSOP-14_4.4x5mm_P0.65mm | 2 fitted; 1 spare(s).
74LVC04AT14-13 | 1 | 2 | $0.3200 | $0.64 | 4004 | $0.2800 | $0.56 | 2760 | DigiKey (https://www.digikey.com/en/products/detail/diodes-incorporated/74LVC04AT14-13/10452774) | Mouser (https://www.mouser.com/ProductDetail/Diodes-Incorporated/74LVC04AT14-13?qs=ZtY9WdtwX56ItyAjeD24GQ%3D%3D) | U2 | BreakoutBoard:TSSOP-14_4.4x5mm_P0.65mm | 1 fitted; 1 spare(s).
M20-9990246 | 2 | 3 | $0.1000 | $0.30 | 179951 | $0.1000 | $0.30 | 98136 | DigiKey (https://www.digikey.com/en/products/detail/harwin-inc/M20-9990246/3728226) | Mouser (https://www.mouser.com/en/ProductDetail/Harwin/M20-9990246?qs=Jph8NoUxIfWjw4WmyRvzag%3D%3D) | TP13, TP14 | Connector_PinHeader_2.54mm:PinHeader_1x02_P2.54mm_Vertical | Fitted headers for TP13 and TP14. The other 21 test points are bare PCB pads. 2 fitted; 1 spare(s).
DigiKey order total | 120 | 144 |  | $49.78 |  | Mouser total | Incomplete
24 spare pieces: 20% extra overall, including at least one spare of every part type. Quantities match the bulk-add text.
Replacements: 10k AC0603FR-0710KL; 100k CRCW0603100KFKEA. Both fit existing 0603 footprints. CAD and Gerbers unchanged.
Mouser AO3401A is search only. Unverified stock and missing USD prices are shown explicitly.
