nischayhegde/jetson_spi_to_can_x8_breakout/componentlist.isolated-reference-2026-10-17.csv

mpn | quantity | function | supplier_url | observed_stock | unit_usd | checked_date | symbol | footprint | step
MCP251863T-E/SS | 8 | Integrated SPI CAN FD controller/transceiver | https://www.digikey.com/en/products/detail/microchip-technology/MCP251863T-E-SS/15985723 | 820 | 2.3 | 2026-10-16 | BreakoutBoard:MCP251863T-E_SS | BreakoutBoard:SSOP-28_5.3x10.2mm_P0.65mm | 3dmodels/SSOP-28_5.3x10.2mm_P0.65mm.step
ABM8G-40.000MHZ-18-D2Y-T | 8 | 40 MHz passive crystal, CL=18 pF | https://www.mouser.com/en/ProductDetail/ABRACON/ABM8G-40.000MHZ-18-D2Y-T?qs=3LVMET7lfiO1sAQRIVmcWA%3D%3D | 1362 |  | 2026-10-16 | BreakoutBoard:ABM8G-40.000MHZ-18-D2Y-T | BreakoutBoard:Crystal_SMD_Abracon_ABM8G-4Pin_3.2x2.5mm | 3dmodels/Crystal_SMD_Abracon_ABM8G-4Pin_3.2x2.5mm.step
ESDONCAN1LT1G | 8 | Dual bidirectional CAN TVS | https://www.mouser.com/en/ProductDetail/onsemi/ESDONCAN1LT1G?qs=xGcJQ%252BnsJwvlHkj2cpk%252Btw%3D%3D | 7124 | 0.55 | 2026-10-16 | BreakoutBoard:ESDONCAN1LT1G | BreakoutBoard:SOT-23 | 3dmodels/SOT-23.step
ISO7763DWR | 4 | Six-channel digital isolator, 3 forward/3 reverse | https://www.mouser.com/en/ProductDetail/Texas-Instruments/ISO7763DWR?qs=BZBei1rCqCCY2ZEA%252BvwxBA%3D%3D | 358 |  | 2026-10-16 | BreakoutBoard:ISO7763DWR | BreakoutBoard:SOIC-16W_7.5x10.3mm_P1.27mm | 3dmodels/SOIC-16W_7.5x10.3mm_P1.27mm.step
TMR 6-0511 | 1 | Regulated isolated 5 V / 1.2 A, 6 W converter | https://www.digikey.com/en/products/detail/traco-power/TMR-6-0511/9383425 | 1085 | 24.18 | 2026-10-16 | BreakoutBoard:TMR_6-0511 | BreakoutBoard:Converter_DCDC_TRACO_TMR-xxxx_THT | 3dmodels/Converter_DCDC_TRACO_TMR-xxxx_THT.step
TPS259530DSGR | 1 | Input eFuse, latch-off, adjustable current limit | https://www.digikey.com/en/products/detail/texas-instruments/TPS259530DSGR/8038175 | 6664 | 1.04 | 2026-10-16 | BreakoutBoard:TPS259530DSGR | BreakoutBoard:WSON-8-1EP_2x2mm_P0.5mm_EP0.9x1.6mm | 3dmodels/WSON-8-1EP_2x2mm_P0.5mm_EP0.9x1.6mm.step
TLV75533PDBVR | 1 | Host-side 3.3 V LDO | https://www.digikey.com/en/products/detail/texas-instruments/TLV75533PDBVR/9356541 | 84540 | 0.45 | 2026-10-16 | BreakoutBoard:TLV75533PDBVR | BreakoutBoard:SOT-23-5 | 3dmodels/SOT-23-5.step
C0603C180J5GACTU | 16 | 18 pF 50 V C0G crystal load capacitor | https://www.digikey.com/en/products/detail/kemet/C0603C180J5GACTU/411054 | 337357 | 0.1 | 2026-10-16 | BreakoutBoard:C0603C180J5GACTU | BreakoutBoard:C_0603_1608Metric | 3dmodels/C_0603_1608Metric.step
CC0603KRX7R9BB104 | 41 | 100 nF 50 V X7R bypass capacitor | https://www.digikey.com/en/products/detail/yageo/CC0603KRX7R9BB104/2103082 | 21441 | 0.14 | 2026-10-16 | BreakoutBoard:CC0603KRX7R9BB104 | BreakoutBoard:C_0603_1608Metric | 3dmodels/C_0603_1608Metric.step
CGA3E1X7R1E105K080AC | 20 | 1 uF 25 V X7R local and LDO capacitor | https://www.digikey.com/en/products/detail/tdk-corporation/CGA3E1X7R1E105K080AC/2672824 | 1048821 |  | 2026-10-16 | BreakoutBoard:CGA3E1X7R1E105K080AC | BreakoutBoard:C_0603_1608Metric | 3dmodels/C_0603_1608Metric.step
CL21B106KOQNNNE | 4 | 10 uF 16 V X7R power bulk capacitor | https://www.digikey.com/en/products/detail/samsung-electro-mechanics/CL21B106KOQNNNE/3890958 | 322235 |  | 2026-10-16 | BreakoutBoard:CL21B106KOQNNNE | BreakoutBoard:C_0805_2012Metric | 3dmodels/C_0805_2012Metric.step
CC0603KRX7R9BB103 | 1 | 10 nF 50 V X7R eFuse slew capacitor | https://www.digikey.com/en/products/detail/yageo/CC0603KRX7R9BB103/302995 | 635615 |  | 2026-10-16 | BreakoutBoard:CC0603KRX7R9BB103 | BreakoutBoard:C_0603_1608Metric | 3dmodels/C_0603_1608Metric.step
RC1206FR-07120RL | 8 | 120 ohm 1% 0.25 W selectable CAN termination | https://www.digikey.com/en/products/detail/yageo/RC1206FR-07120RL/728523 | 65122 | 0.1 | 2026-10-16 | BreakoutBoard:RC1206FR-07120RL | BreakoutBoard:R_1206_3216Metric | 3dmodels/R_1206_3216Metric.step
RC0603FR-0710KL | 24 | 10 kohm 1% CS/IRQ/MISO bias | https://www.digikey.com/en/products/detail/yageo/RC0603FR-0710KL/729827 | 1215724 | 0.1 | 2026-10-16 | BreakoutBoard:RC0603FR-0710KL | BreakoutBoard:R_0603_1608Metric | 3dmodels/R_0603_1608Metric.step
RC0603FR-0733RL | 14 | 33 ohm 1% SPI source damping | https://www.mouser.com/en/ProductDetail/YAGEO/RC0603FR-0733RL?qs=diQw95jMAeMotgif2GSHTQ%3D%3D | 595649 | 0.1 | 2026-10-16 | BreakoutBoard:RC0603FR-0733RL | BreakoutBoard:R_0603_1608Metric | 3dmodels/R_0603_1608Metric.step
CRCW06031K21FKEA | 1 | 1.21 kohm 1% eFuse ILM setting | https://www.digikey.com/en/products/detail/vishay-dale/CRCW06031K21FKEA/1179818 | 49852 | 0.1 | 2026-10-16 | BreakoutBoard:CRCW06031K21FKEA | BreakoutBoard:R_0603_1608Metric | 3dmodels/R_0603_1608Metric.step
B3B-XH-A | 8 | 3-pin 2.50 mm CAN connector | https://www.digikey.com/en/products/detail/jst-sales-america-inc/B3B-XH-A/1651046 | 69190 | 0.13 | 2026-10-16 | BreakoutBoard:B3B-XH-A | BreakoutBoard:JST_XH_B3B-XH-A_1x03_P2.50mm_Vertical | 3dmodels/JST_XH_B3B-XH-A_1x03_P2.50mm_Vertical.step
B2B-XH-A | 1 | 2-pin 2.50 mm 5 V input connector | https://www.digikey.com/en/products/detail/jst-sales-america-inc/B2B-XH-A/1651045 | 304650 |  | 2026-10-16 | BreakoutBoard:B2B-XH-A | BreakoutBoard:JST_XH_B2B-XH-A_1x02_P2.50mm_Vertical | 3dmodels/JST_XH_B2B-XH-A_1x02_P2.50mm_Vertical.step
M20-9982046 | 1 | 2x20 2.54 mm host harness header | https://www.digikey.com/en/products/detail/harwin-inc/M20-9982046/3921209 | 1525 | 1.34 | 2026-10-16 | BreakoutBoard:M20-9982046 | BreakoutBoard:PinHeader_2x20_P2.54mm_Vertical | 3dmodels/PinHeader_2x20_P2.54mm_Vertical.step
0466002.NR | 1 | 2 A 63 V fast-acting series input fuse, 1206 | https://www.digikey.com/en/products/detail/littelfuse-inc/0466002-NR/521355 | 9900 | 1.25 | 2026-10-17 | BreakoutBoard:0466002.NR | BreakoutBoard:Fuse_1206_3216Metric | 3dmodels/Fuse_1206_3216Metric.step
STPS20L15D | 1 | 15 V 20 A shunt reverse-polarity Schottky, qualification required | https://www.digikey.com/en/products/detail/stmicroelectronics/STPS20L15D/1039632 | 1157 | 2.18 | 2026-10-17 | BreakoutBoard:STPS20L15D | BreakoutBoard:TO-220-2_Vertical | 3dmodels/TO-220-2_Vertical.step
74LVC08APW,118 | 2 | Quad 2-input AND, 3.3 V host-side CS bank logic | https://www.digikey.com/en/products/detail/nexperia-usa-inc/74LVC08APW-118/2209917 | 17941 | 0.23 | 2026-10-17 | BreakoutBoard:74LVC08APW,118 | BreakoutBoard:TSSOP-14_4.4x5mm_P0.65mm | 3dmodels/TSSOP-14_4.4x5mm_P0.65mm.step
74AHC30PW,118 | 1 | 8-input NAND plus spare NOT implements shared-IRQ AND | https://www.mouser.com/ProductDetail/Nexperia/74AHC30PW118?qs=P62ublwmbi%252B963Q4ACANGA%3D%3D | 3795 | 0.39 | 2026-10-17 | BreakoutBoard:74AHC30PW,118 | BreakoutBoard:TSSOP-14_4.4x5mm_P0.65mm | 3dmodels/TSSOP-14_4.4x5mm_P0.65mm.step
74LVC32APW,118 | 1 | Quad 2-input OR, 3.3 V host-side logic provision | https://www.digikey.com/en/products/detail/nexperia-usa-inc/74LVC32APW-118/946666 | 6092 | 0.25 | 2026-10-17 | BreakoutBoard:74LVC32APW,118 | BreakoutBoard:TSSOP-14_4.4x5mm_P0.65mm | 3dmodels/TSSOP-14_4.4x5mm_P0.65mm.step
74LVC04AT14-13 | 3 | Hex inverter, 3.3 V host-side CS bank logic | https://www.digikey.com/en/products/detail/diodes-incorporated/74LVC04AT14-13/10452774 | 3994 | 0.32 | 2026-10-17 | BreakoutBoard:74LVC04AT14-13 | BreakoutBoard:TSSOP-14_4.4x5mm_P0.65mm | 3dmodels/TSSOP-14_4.4x5mm_P0.65mm.step
