nischayhegde/jetson_spi_to_can_x8_breakout/datasheets/download_manifest.csv

mpn | filename | document | source_url | status | bytes | sha256 | checked_utc | error | resolved_url
MCP251863T-E/SS | MCP251863T-E_SS.pdf | Microchip device datasheet | https://ww1.microchip.com/downloads/aemDocuments/documents/APID/ProductDocuments/DataSheets/MCP251863-Data-Sheet-DS20006624A.pdf | present | 1028685 | 88a35dc5bc412ca2ff9e7ef4d37fd4cf78c7237a24ed48ae5bfc355e0295b8a9 | 2026-10-18T21:47:27.042548+00:00
ABM8G-40.000MHZ-18-D2Y-T | ABM8G-40.000MHZ-18-D2Y-T.pdf | Abracon ABM8G family datasheet; selected options encoded in MPN | https://abracon.com/Resonators/ABM8G.pdf | present | 1385782 | 232c973118b76d246d51789118b3e7fa7ce6252e94e2dfc4ca3999436bd0c788 | 2026-10-18T21:47:27.042916+00:00
ESDONCAN1LT1G | ESDONCAN1LT1G.pdf | onsemi ESDONCAN1 device datasheet, distributor-hosted older revision | https://www.farnell.com/datasheets/2337848.pdf | present | 81404 | 13341543c35d163fe59a97370a5cf5da45138ddcd30b37d5e314eb5e429a30d4 | 2026-10-18T21:47:27.043368+00:00
ISO7763DWR | ISO7763DWR.pdf | TI ISO776x family datasheet | https://www.ti.com/lit/ds/symlink/iso7763.pdf | present | 2291676 | fc874e117ffefc489c82677a76580002a55c9dfd0bec7c800af8300dbbf8ff22 | 2026-10-18T21:47:27.043979+00:00
TMR 6-0511 | TMR_6-0511.pdf | TRACO TMR 6 family datasheet | https://www.tracopower.com/products/tmr6.pdf | present | 821061 | a40d29d764adc69c35f18f8450c8b9577dffe4679661989264ba2e0d8f5195dd | 2026-10-18T21:47:27.044344+00:00
TPS259530DSGR | TPS259530DSGR.pdf | TI TPS2595 family datasheet | https://www.ti.com/lit/ds/symlink/tps2595.pdf | present | 5415611 | 6a8b67ad925b6fa88d7f3fccd94a3fc4f7c8d3f8a22abecbdfdc3c33f63f0d25 | 2026-10-18T21:47:27.045164+00:00
TLV75533PDBVR | TLV75533PDBVR.pdf | TI TLV755P family datasheet | https://www.ti.com/lit/ds/symlink/tlv755p.pdf | present | 3073217 | 945e5ba0323addcda19fccc311b6791edc843725b25a62ca128e5ccdf0988ef1 | 2026-10-18T21:47:27.045752+00:00
CL10C270JB8NNNC | CL10C270JB8NNNC.pdf | Samsung exact-part specification sheet, distributor-hosted copy; 27 pF C0G 50 V +/-5%, 0603 | https://www1.futureelectronics.com/doc/Samsung%20Electro-Mechanics/CL10C270JB8NNNC.pdf | present | 1362471 | d85634560ba1c9bacd66ca465bcc06087f295f68b991ff6f7dac87e6c1b1c097 | 2026-10-18T21:47:27.046012+00:00
CC0603KRX7R9BB104 | CC0603KRX7R9BB104.pdf | YAGEO exact-part specification sheet | https://yageogroup.com/download/specsheet/CC0603KRX7R9BB104 | present | 285424 | 27afdb408ceeabee829b1a969acbdf38005fffb10fa126c2c9af784b6c114cd9 | 2026-10-18T21:47:27.047566+00:00
CGA3E1X7R1E105K080AC | CGA3E1X7R1E105K080AC.pdf | TDK CGA series specification, distributor-hosted copy listing selected MPN | https://www.farnell.com/datasheets/1735392.pdf | present | 1709843 | 4c0b180012c09492ca6c636caa9baa38d5216981d565ac5069723dc67719e463 | 2026-10-18T21:47:27.048650+00:00
CL21B106KOQNNNE | CL21B106KOQNNNE.pdf | Samsung CL series datasheet linked by DigiKey for selected MPN | https://mm.digikey.com/Volume0/opasdata/d220001/medias/docus/926/CL_Series_MLCC_ds.pdf | present | 373613 | 07d5b0ec861b16df570af962387da02677542d2605196094568a7b8fe3824f8d | 2026-10-18T21:47:27.050478+00:00
CC0603KRX7R9BB103 | CC0603KRX7R9BB103.pdf | YAGEO exact-part specification sheet | https://yageogroup.com/download/specsheet/CC0603KRX7R9BB103 | present | 263686 | acaeff6696f4130d6d12c6a33cbf3a2417677eef015e50b66f8d72411093fe40 | 2026-10-18T21:47:27.050737+00:00
RC1206FR-07120RL | RC1206FR-07120RL.pdf | YAGEO RC_L family datasheet | https://yageogroup.com/content/datasheet/asset/file/PYU-RC_GROUP_51_ROHS_L | present | 542969 | 7b6f0ae72708ca4b38126f84b5407a3e970a94cb60bc1a0afdaeb25a23d839bb | 2026-10-18T21:47:27.051459+00:00
RC0603FR-0710KL | RC0603FR-0710KL.pdf | YAGEO RC_L family datasheet | https://yageogroup.com/content/datasheet/asset/file/PYU-RC_GROUP_51_ROHS_L | present | 542969 | 7b6f0ae72708ca4b38126f84b5407a3e970a94cb60bc1a0afdaeb25a23d839bb | 2026-10-18T21:47:27.052409+00:00
RC0603FR-0733RL | RC0603FR-0733RL.pdf | YAGEO RC_L family datasheet | https://yageogroup.com/content/datasheet/asset/file/PYU-RC_GROUP_51_ROHS_L | present | 542969 | 7b6f0ae72708ca4b38126f84b5407a3e970a94cb60bc1a0afdaeb25a23d839bb | 2026-10-18T21:47:27.052856+00:00
CRCW06031K21FKEA | CRCW06031K21FKEA.pdf | Vishay D/CRCW e3 family datasheet | https://www.vishay.com/doc?20035= | present | 150402 | afc802f23472a8243e24e9240046b96902829d5c6f9f3bfc9c14507ea6e955e1 | 2026-10-18T21:47:27.053186+00:00
B3B-XH-A | B3B-XH-A.pdf | JST XH series specification and dimensions | https://www.jst-mfg.com/product/pdf/eng/eXH.pdf | present | 175724 | 9426b136902f11900825077535e5c65032b7fbc31ffb59c5e9e1f463bb20fb90 | 2026-10-18T21:47:27.053491+00:00
B2B-XH-A | B2B-XH-A.pdf | JST XH series specification and dimensions | https://www.jst-mfg.com/product/pdf/eng/eXH.pdf | present | 175724 | 9426b136902f11900825077535e5c65032b7fbc31ffb59c5e9e1f463bb20fb90 | 2026-10-18T21:47:27.054154+00:00
M20-9982046 | M20-9982046.pdf | Harwin M20 component specification; also download M20-998 drawing | https://content.harwin.com/m/7d31e750480889aa/original/C001-C001XX-Component-Specification-M20-Series-2-54mm-pitch-PCB-connectors.pdf | present | 219467 | 886a13d7e7e8d0b1546a685b321fdaeeca5a596eafe4769e2911d8af88fab403 | 2026-10-18T21:47:27.054509+00:00
0466001.NR | 0466001.NR.pdf | Littelfuse 466 family datasheet, distributor-hosted copy including the selected 1 A row; current manufacturer link in BOM/symbol | https://www.farnell.com/datasheets/3741073.pdf | present | 595425 | ebee7a32aa7450052cf004f8d62c0cb8723cab715d0899300c47d852747ef72f | 2026-10-18T21:47:27.054764+00:00
AO3401A | AO3401A.pdf | Alpha & Omega Semiconductor AO3401A Rev. 3.1 (December 2023), original manufacturer datasheet | https://www.aosmd.com/sites/default/files/res/datasheets/AO3401A.pdf | present | 326568 | 0d8e3261ae280e007b5837fff60c55142f2d92af71edc4d02aee6f7a760a785c | 2026-10-18T21:47:27.055022+00:00
BZT52C6V8-13-F | BZT52C6V8-13-F.pdf | Diodes Incorporated DS18004 Rev. 32-2 (June 2008), DigiKey-hosted original manufacturer family datasheet including 6.8 V and -13-F packaging; current manufacturer sheet linked in BOM/symbol | https://media.digikey.com/pdf/Data%20Sheets/Diodes%20PDFs/BZT52CV0%20-%20BZT52C39.pdf | present | 168887 | 26539c9914dfcb914d67973c2b08d272f7cb64a2dfe389808c2f6b246a1c5f35 | 2026-10-18T21:47:27.055457+00:00
74LVC08APW,118 | 74LVC08APW_118.pdf | Nexperia quad AND gate datasheet Rev. 11, distributor-hosted copy; latest Rev. 12 linked in symbol/BOM | https://store.comet.bg/download-file.php?id=14759 | present | 241132 | d95a840ae04df82cbbd4c1b4909d9d89bd4a2a6e77e4cccc5d69b5c340307153 | 2026-10-18T21:47:27.055977+00:00
74AHC30PW,118 | 74AHC30PW_118.pdf | Nexperia 74AHC/74AHCT30 older manufacturer datasheet from public mirror; current Rev. 8 reviewed online and linked in BOM/symbol | https://docs.ampnuts.ru/nexperia.com.datasheet/74AHC_AHCT30.pdf | present | 256863 | a2abddce41e657ba49a8f4e04460253d892f3d344b362e14cf86e33a4ddfe3a2 | 2026-10-18T21:47:27.056320+00:00
74LVC32APW,118 | 74LVC32APW_118.pdf | NXP 74LVC32A Rev. 5 (2011), distributor-hosted predecessor-brand datasheet; current Nexperia Rev. 11 linked in BOM/symbol | https://www.farnell.com/datasheets/1645516.pdf | present | 115985 | 30731bfa33d83191cbd6ef2a34575abbf7c8790e18e24327b4c1bb63fdfeb848 | 2026-10-18T21:47:27.056935+00:00
74LVC04AT14-13 | 74LVC04AT14-13.pdf | Diodes Incorporated hex inverter datasheet | https://www.diodes.com/assets/Datasheets/74LVC04A.pdf | present | 786536 | cf0dae700efde6ea7c380db84d1d2577b47aa95ee32441f114864a1a6441b986 | 2026-10-18T21:47:27.057107+00:00
Supplement | M20-998_Drawing.pdf | Harwin M20-998 family dimensional drawing | https://content.harwin.com/asset/1590d228-db5c-4836-ab0c-0f146730b624/DRG-00478-Technical-Drawing-Datasheet-M20-998-pdf.pdf | present | 49082 | 05d6377c688046aef738a839253496481ec748d5123445d4a8b0b38173232f86 | 2026-10-18T21:47:27.057230+00:00
Supplement | MCP251863_Board_Design_Hints.pdf | Microchip board design application note | https://ww1.microchip.com/downloads/aemDocuments/documents/APID/ApplicationNotes/ApplicationNotes/MCP251863-Application-Note-00004560A.pdf | present | 193079 | d3da96826d7134c5dba56c6cca31f619e3458fbb9a887c0603b979da80654e34 | 2026-10-18T21:47:27.057798+00:00
Supplement | MOSFET_Reverse_Protection_TI.pdf | TI Basics of Ideal Diodes, P-channel reverse-hookup topology and reverse-current limitations | https://www.ti.com/lit/an/slvae57/slvae57.pdf | present | 2438794 | 6c323736a0126b548af02db3f911aa085c283c181384a7a348f40126a12addb3 | 2026-10-18T21:47:27.058076+00:00
