nischayhegde/jetson_spi_to_can_x8_breakout/bulk_order_digikey.txt

9, 150-MCP251863T-E/SSCT-ND
9, 535-10281-1-ND
2, 296-50411-1-ND
18, 1276-1086-1-ND
30, 311-1344-1-ND
3, 445-6931-1-ND
2, 1276-2872-1-ND
9, 311-120FRCT-ND
10, 311-10KLDCT-ND
5, 541-100KHCT-ND
18, 13-RC0603FR-0733RLCT-ND
9, 455-2248-ND
2, 455-B2B-XH-A-ND
2, M20-7832046
2, F1456CT-ND
2, 785-1001-1-ND
2, 31-BZT52C6V8-13-FCT-ND
2, 1727-7291-1-ND
3, 1727-3081-1-ND
2, 31-74LVC04AT14-13CT-ND
3, 952-2262-ND
