nischayhegde/jetson_spi_to_can_x8_breakout/review/orderlist-2026-10-29/orderlist-preview.png

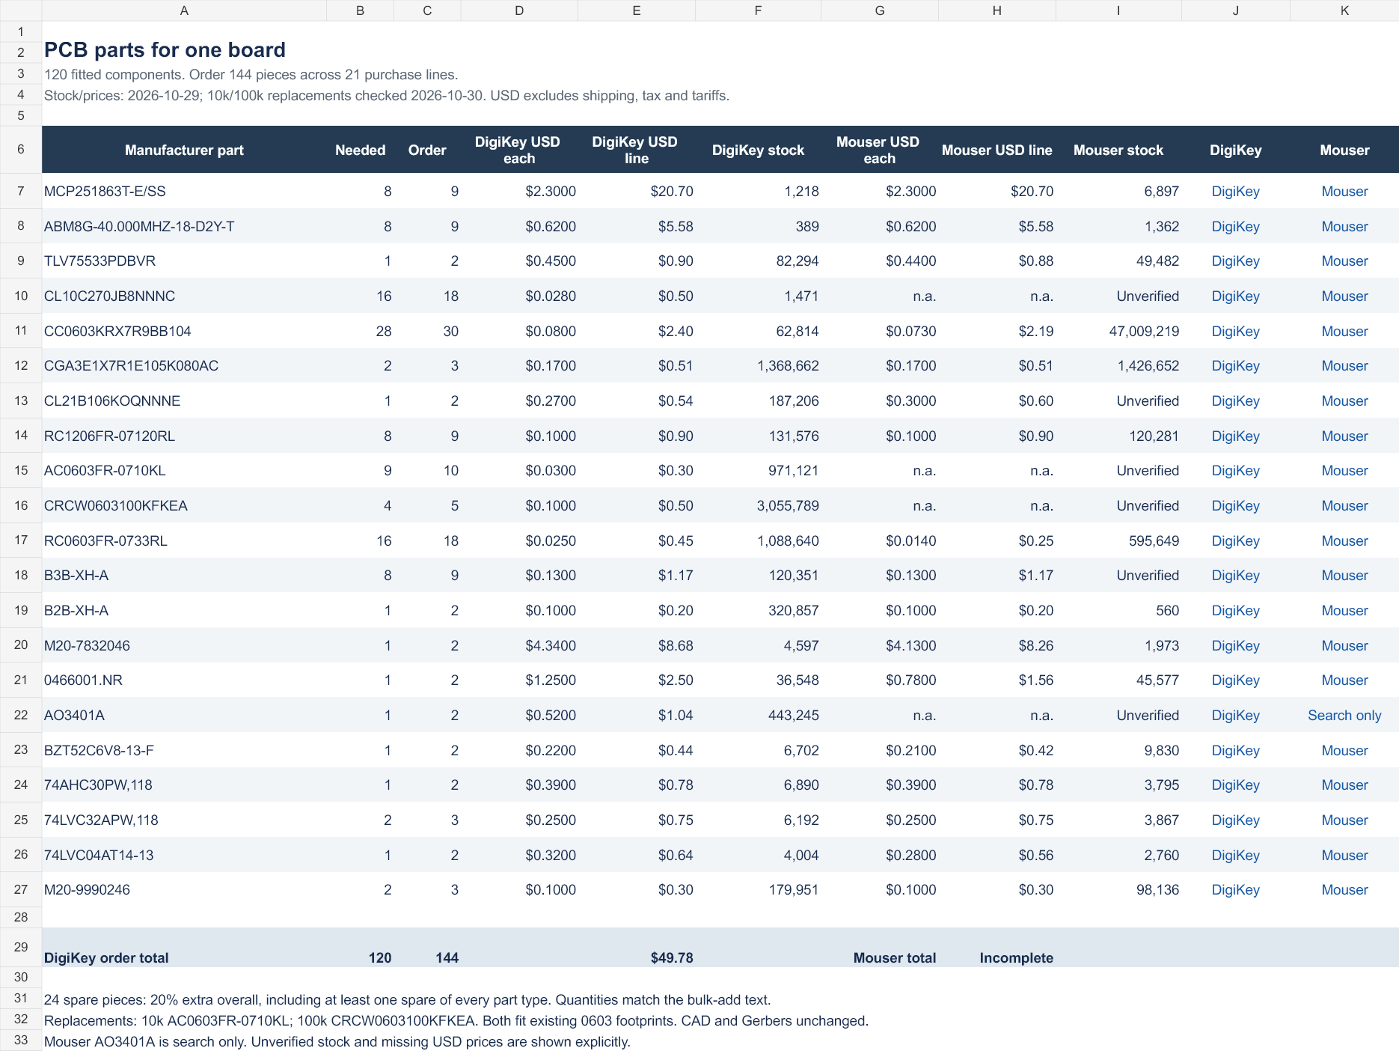
review/orderlist-2026-10-29/orderlist-preview.png
