nischayhegde/jetson_spi_to_can_x8_breakout/kicad_footprints/3dmodels/PinSocket_2x20_P2.54mm_Vertical.step

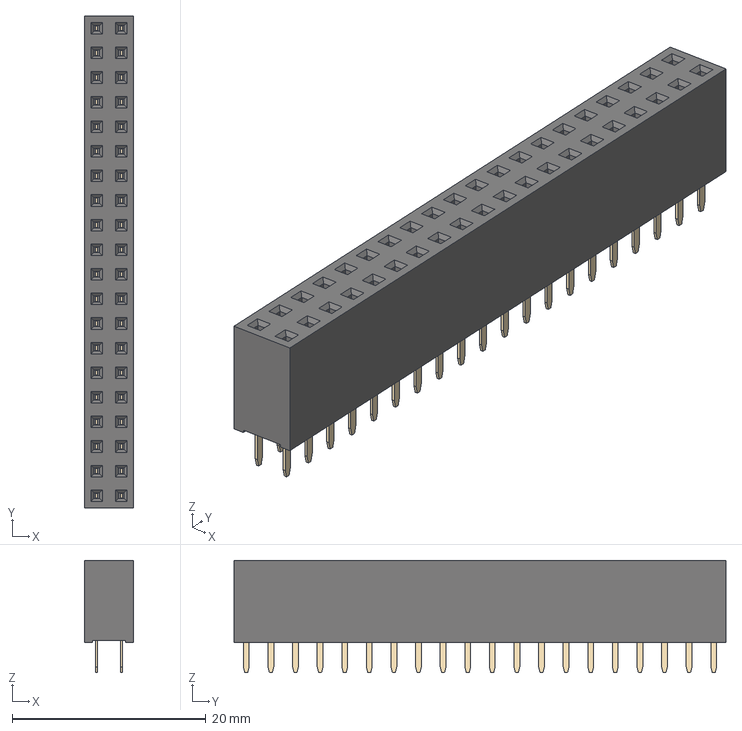
[picture p26: CAD file, 2026-10-29]
kicad_footprints/3dmodels/PinSocket_2x20_P2.54mm_Vertical.step
5.08 x 50.8 x 11.6 mm
