nischayhegde/jetson_spi_to_can_x8_breakout/output/assembly/back-assembly-map.png

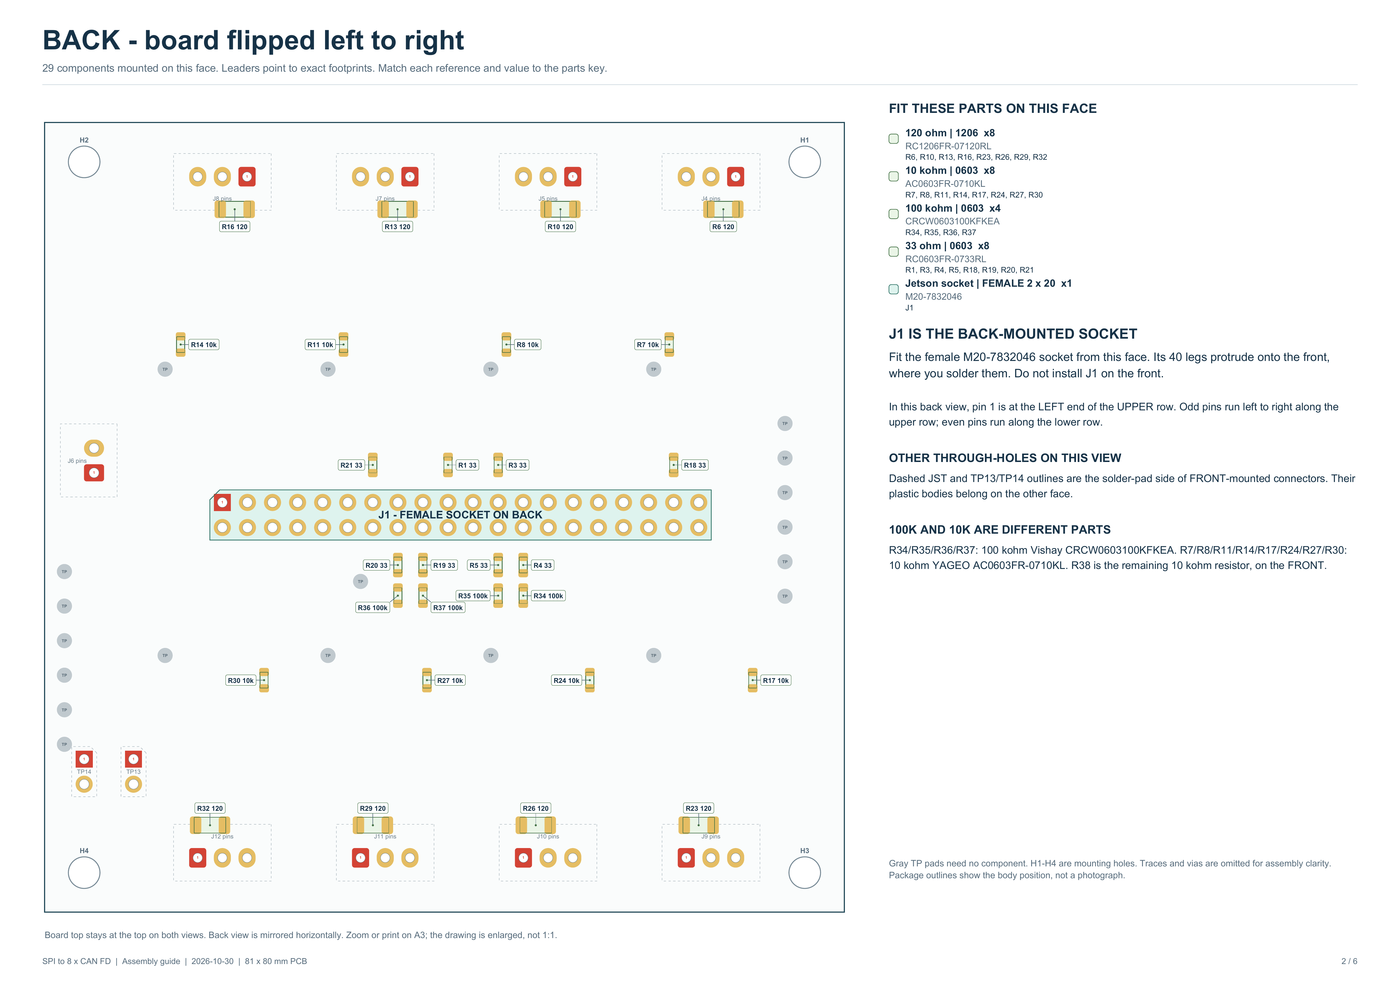
output/assembly/back-assembly-map.png
