nischayhegde/jetson_spi_to_can_x8_breakout/output/assembly/front-assembly-map.png

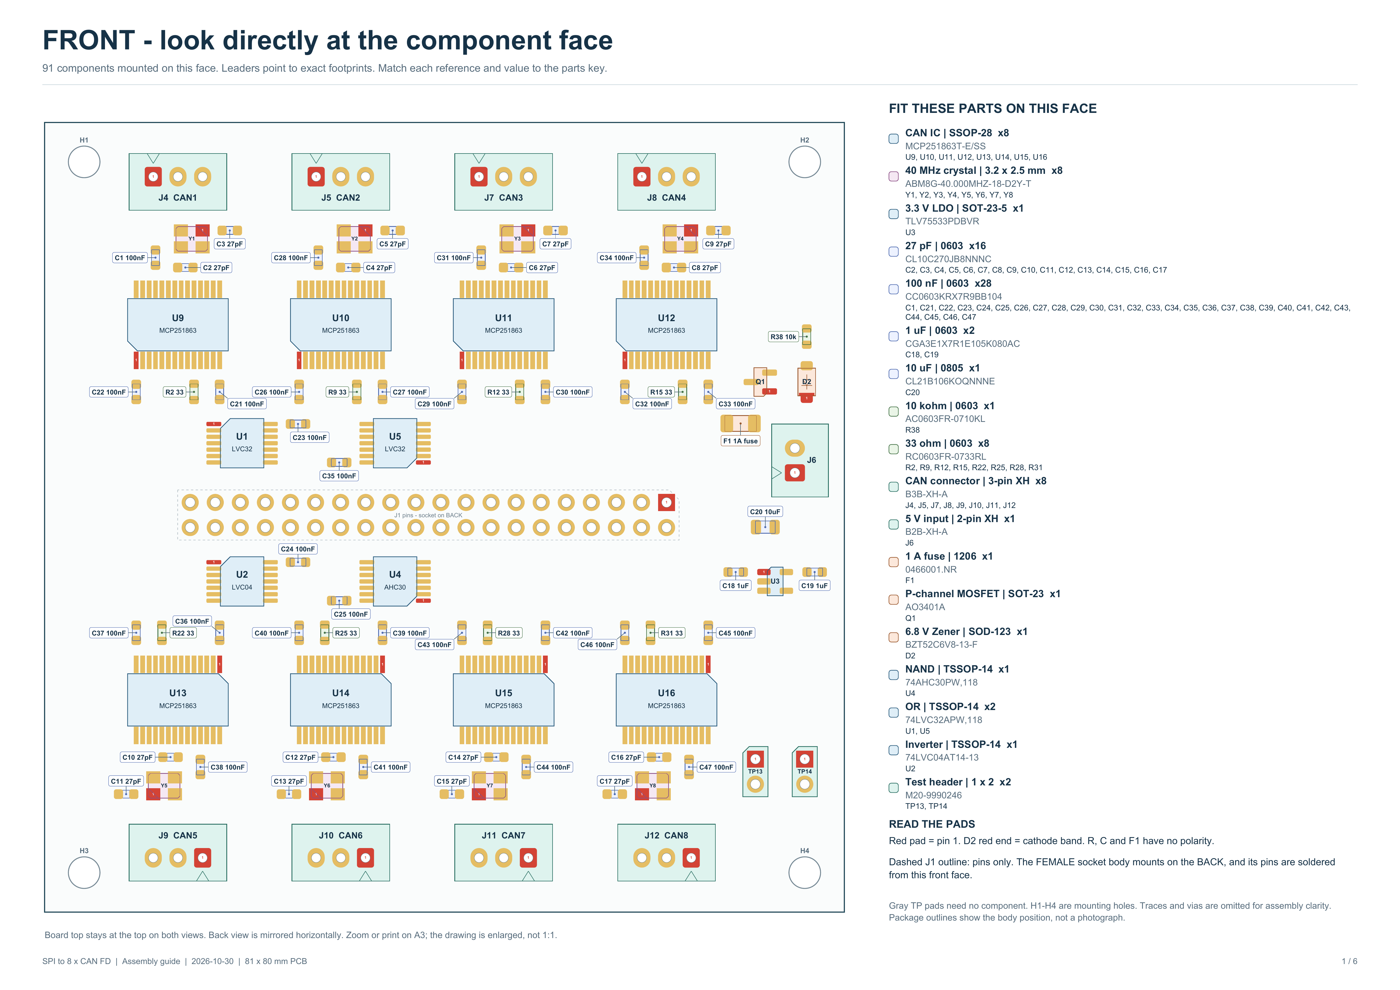
output/assembly/front-assembly-map.png
