nischayhegde/jetson_spi_to_can_x8_breakout/review/assembly-guide-2026-10-30/page-2.png

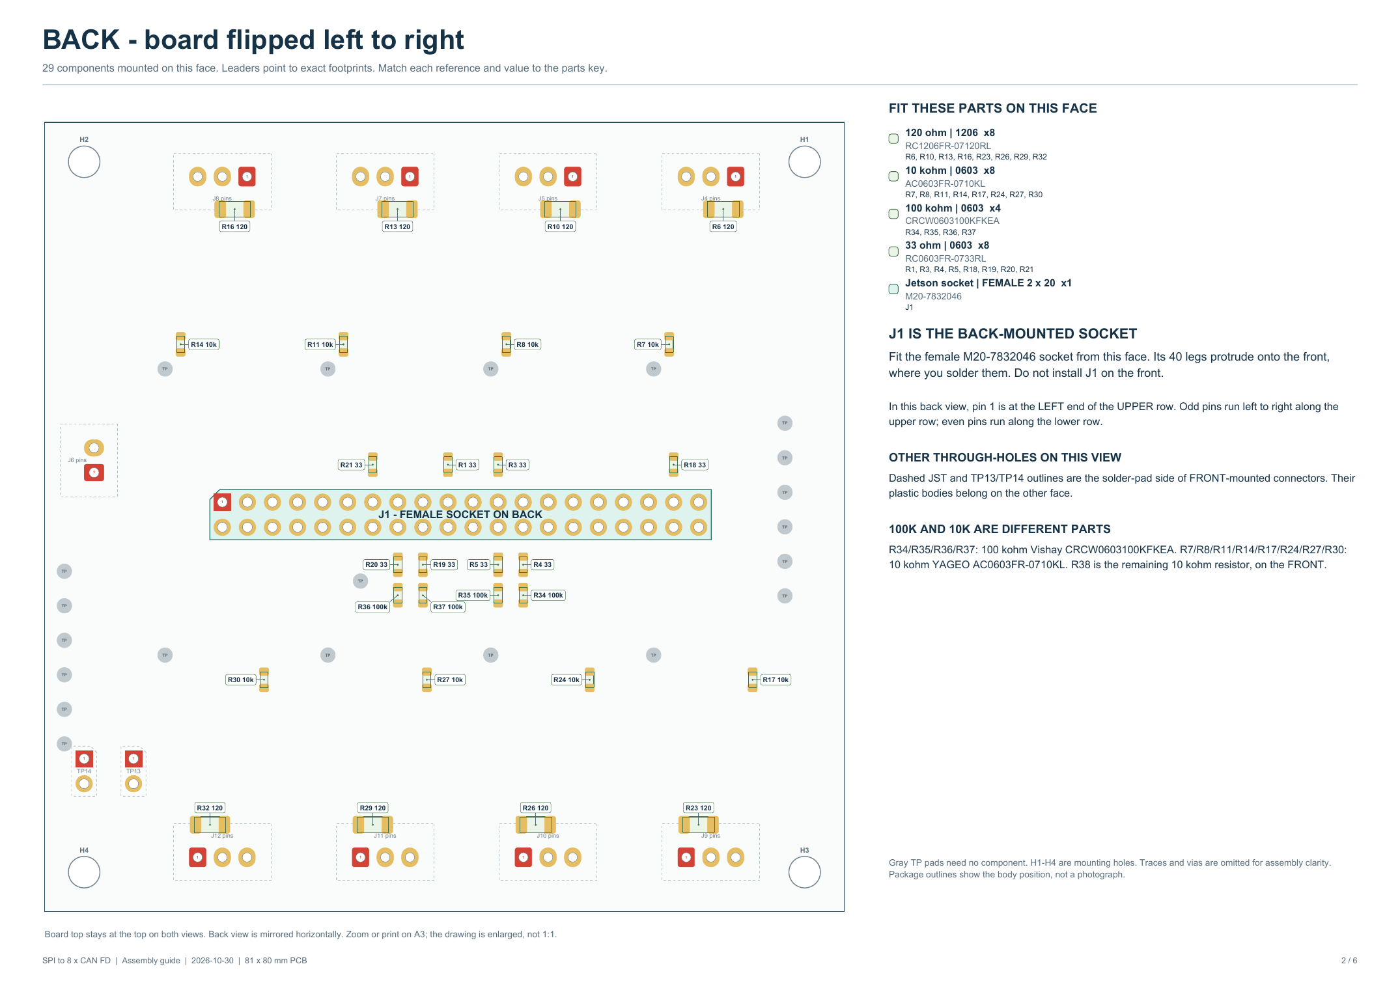
review/assembly-guide-2026-10-30/page-2.png
