nischayhegde/jetson_spi_to_can_x8_breakout/review/fabrication-2026-10-29/breakout-NPTH-drl_map.png

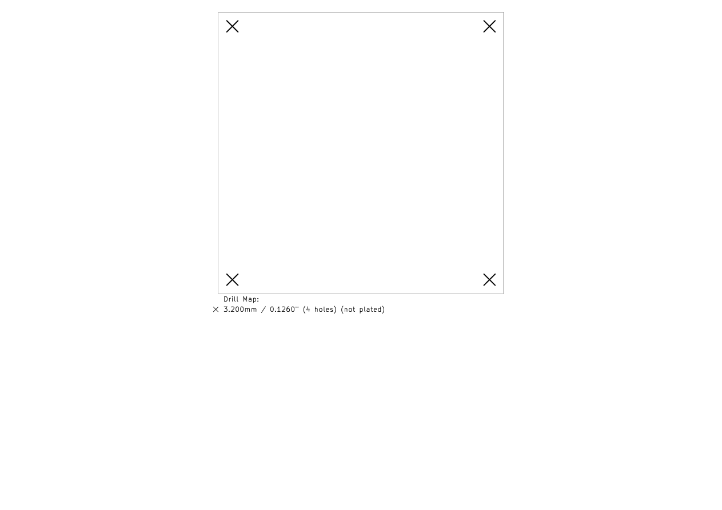
review/fabrication-2026-10-29/breakout-NPTH-drl_map.png
