nischayhegde/jetson_spi_to_can_x8_breakout/datasheets/validation.txt

PASS MCP251863T-E_SS.pdf: 106 pages parsed; SHA-256 matches manifest
PASS ABM8G-40.000MHZ-18-D2Y-T.pdf: 2 pages parsed; SHA-256 matches manifest
PASS ESDONCAN1LT1G.pdf: 5 pages parsed; SHA-256 matches manifest
PASS ISO7763DWR.pdf: 52 pages parsed; SHA-256 matches manifest
PASS TMR_6-0511.pdf: 4 pages parsed; SHA-256 matches manifest
PASS TPS259530DSGR.pdf: 49 pages parsed; SHA-256 matches manifest
PASS TLV75533PDBVR.pdf: 51 pages parsed; SHA-256 matches manifest
PASS CL10C270JB8NNNC.pdf: 36 pages parsed; SHA-256 matches manifest
PASS CC0603KRX7R9BB104.pdf: 4 pages parsed; SHA-256 matches manifest
PASS CGA3E1X7R1E105K080AC.pdf: 19 pages parsed; SHA-256 matches manifest
PASS CL21B106KOQNNNE.pdf: 21 pages parsed; SHA-256 matches manifest
PASS CC0603KRX7R9BB103.pdf: 4 pages parsed; SHA-256 matches manifest
PASS RC1206FR-07120RL.pdf: 11 pages parsed; SHA-256 matches manifest
PASS RC0603FR-0710KL.pdf: 11 pages parsed; SHA-256 matches manifest
PASS RC0603FR-0733RL.pdf: 11 pages parsed; SHA-256 matches manifest
PASS CRCW06031K21FKEA.pdf: 13 pages parsed; SHA-256 matches manifest
PASS B3B-XH-A.pdf: 9 pages parsed; SHA-256 matches manifest
PASS B2B-XH-A.pdf: 9 pages parsed; SHA-256 matches manifest
PASS M20-9982046.pdf: 4 pages parsed; SHA-256 matches manifest
PASS 0466001.NR.pdf: 3 pages parsed; SHA-256 matches manifest
PASS AO3401A.pdf: 5 pages parsed; SHA-256 matches manifest
PASS BZT52C6V8-13-F.pdf: 4 pages parsed; SHA-256 matches manifest
PASS 74LVC08APW_118.pdf: 12 pages parsed; SHA-256 matches manifest
PASS 74AHC30PW_118.pdf: 16 pages parsed; SHA-256 matches manifest
PASS 74LVC32APW_118.pdf: 14 pages parsed; SHA-256 matches manifest
PASS 74LVC04AT14-13.pdf: 10 pages parsed; SHA-256 matches manifest
PASS M20-998_Drawing.pdf: 1 pages parsed; SHA-256 matches manifest
PASS MCP251863_Board_Design_Hints.pdf: 11 pages parsed; SHA-256 matches manifest
PASS MOSFET_Reverse_Protection_TI.pdf: 25 pages parsed; SHA-256 matches manifest
PASS 29/29 manifest PDFs present and parsed
