nischayhegde/jetson_spi_to_can_x8_breakout/review/verification-2026-10-25/bandwidth.csv

extended | dlc | can_bits_min_including_intermission | frame_rate_upper_bound_per_channel | model | spi_bytes_per_frame | required_spi_mbit_per_bus | utilization_10MHz | utilization_16MHz | utilization_17MHz | gap_budget_us_per_frame_at_16MHz | total_eight_channel_frame_rate | max_stuff_bits_bound
False | 0 | 47 | 21276.59574468085 | RX_CRC_amortized_status | 23 | 15.659574468085104 | 1.5659574468085105 | 0.978723404255319 | 0.9211514392991238 | 0.25 | 170212.7659574468 | 8
False | 0 | 47 | 21276.59574468085 | RX_CRC_two_status_reads_per_frame | 41 | 27.914893617021274 | 2.7914893617021272 | 1.7446808510638296 | 1.6420525657071336 | -8.75 | 170212.7659574468 | 8
False | 0 | 47 | 21276.59574468085 | TX_CRC_and_timestamped_TEF_amortized_status | 42 | 28.595744680851062 | 2.859574468085106 | 1.7872340425531914 | 1.6821026282853566 | -9.25 | 170212.7659574468 | 8
False | 0 | 47 | 21276.59574468085 | TX_CRC_and_TEF_two_status_reads_per_frame | 60 | 40.85106382978723 | 4.085106382978723 | 2.553191489361702 | 2.4030037546933665 | -18.25 | 170212.7659574468 | 8
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
