nischayhegde/jetson_spi_to_can_x8_breakout/review/verification-2026-10-25/RobStride04-protocol-p18.png

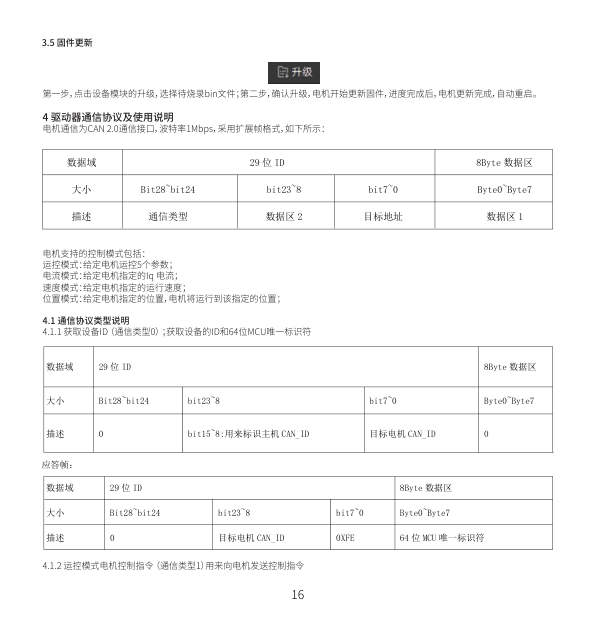
review/verification-2026-10-25/RobStride04-protocol-p18.png
