nischayhegde/jetson_spi_to_can_x8_breakout/(list of files, drawings)

Other design files:
review/j1-ground-fix-2026-10-25/pcb_change.json
review/j1-ground-fix-2026-10-25/schematic_change.json
review/standardization-2026-10-29/pcb-change.json
review/standardization-2026-10-29/pcb-package-intermediate-change.json
review/standardization-2026-10-29/schematic-change.json
