nischayhegde/jetson_spi_to_can_x8_breakout/breakout/breakout.kicad_pcb

## KiCad design breakout/breakout.kicad_pcb (2026-10-29)

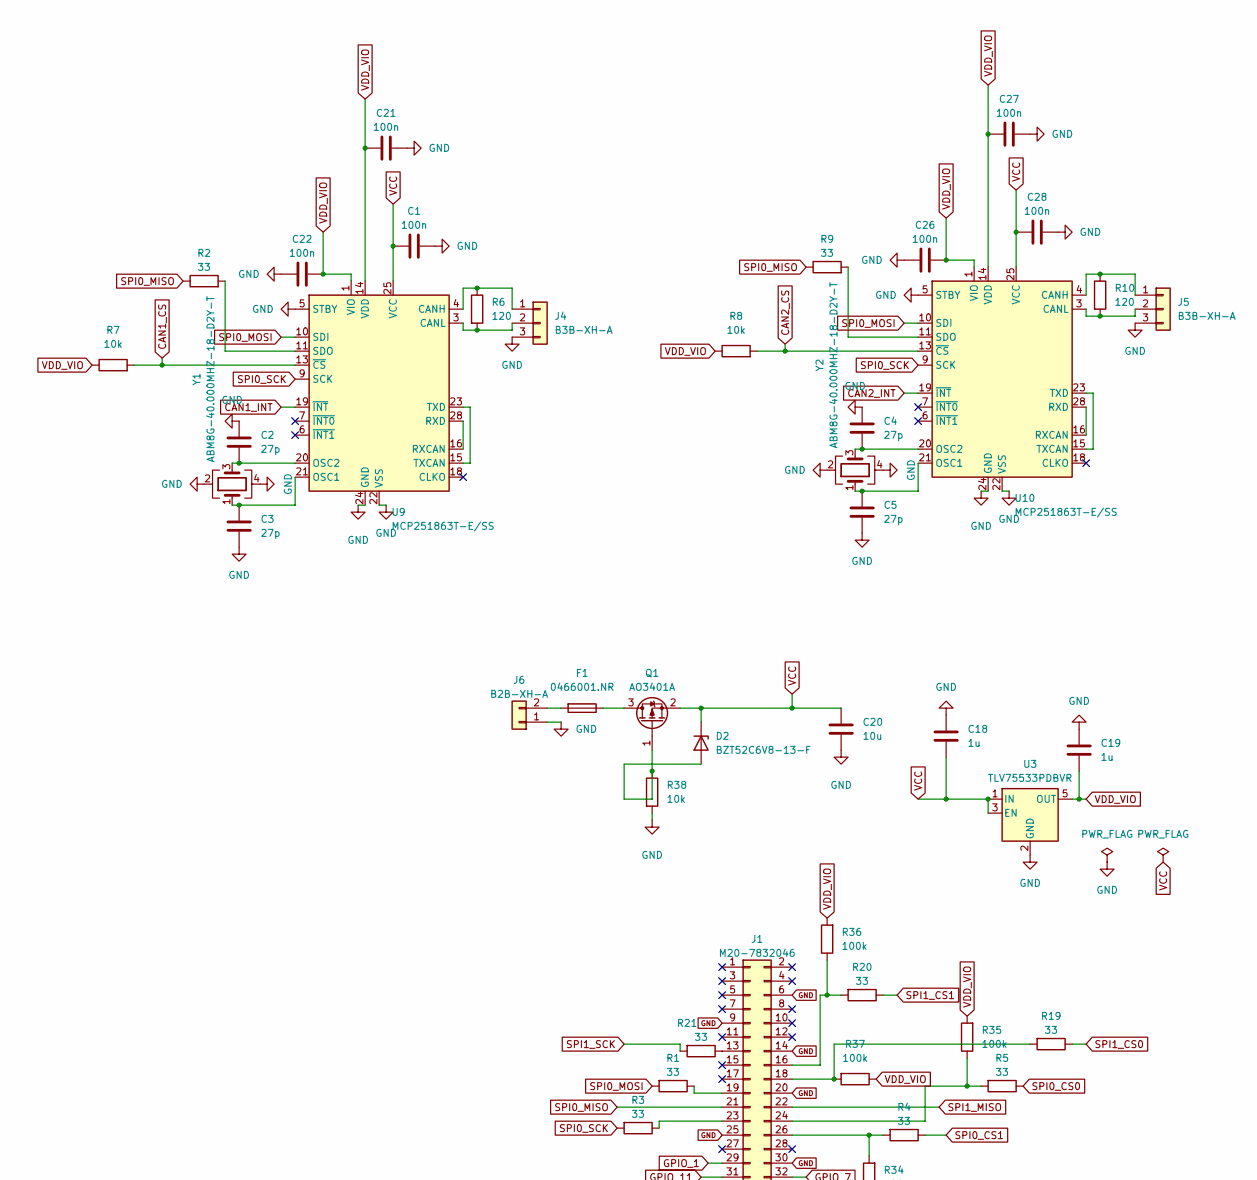
[picture p59: schematic breakout.kicad_sch, part in row 1, column 1]

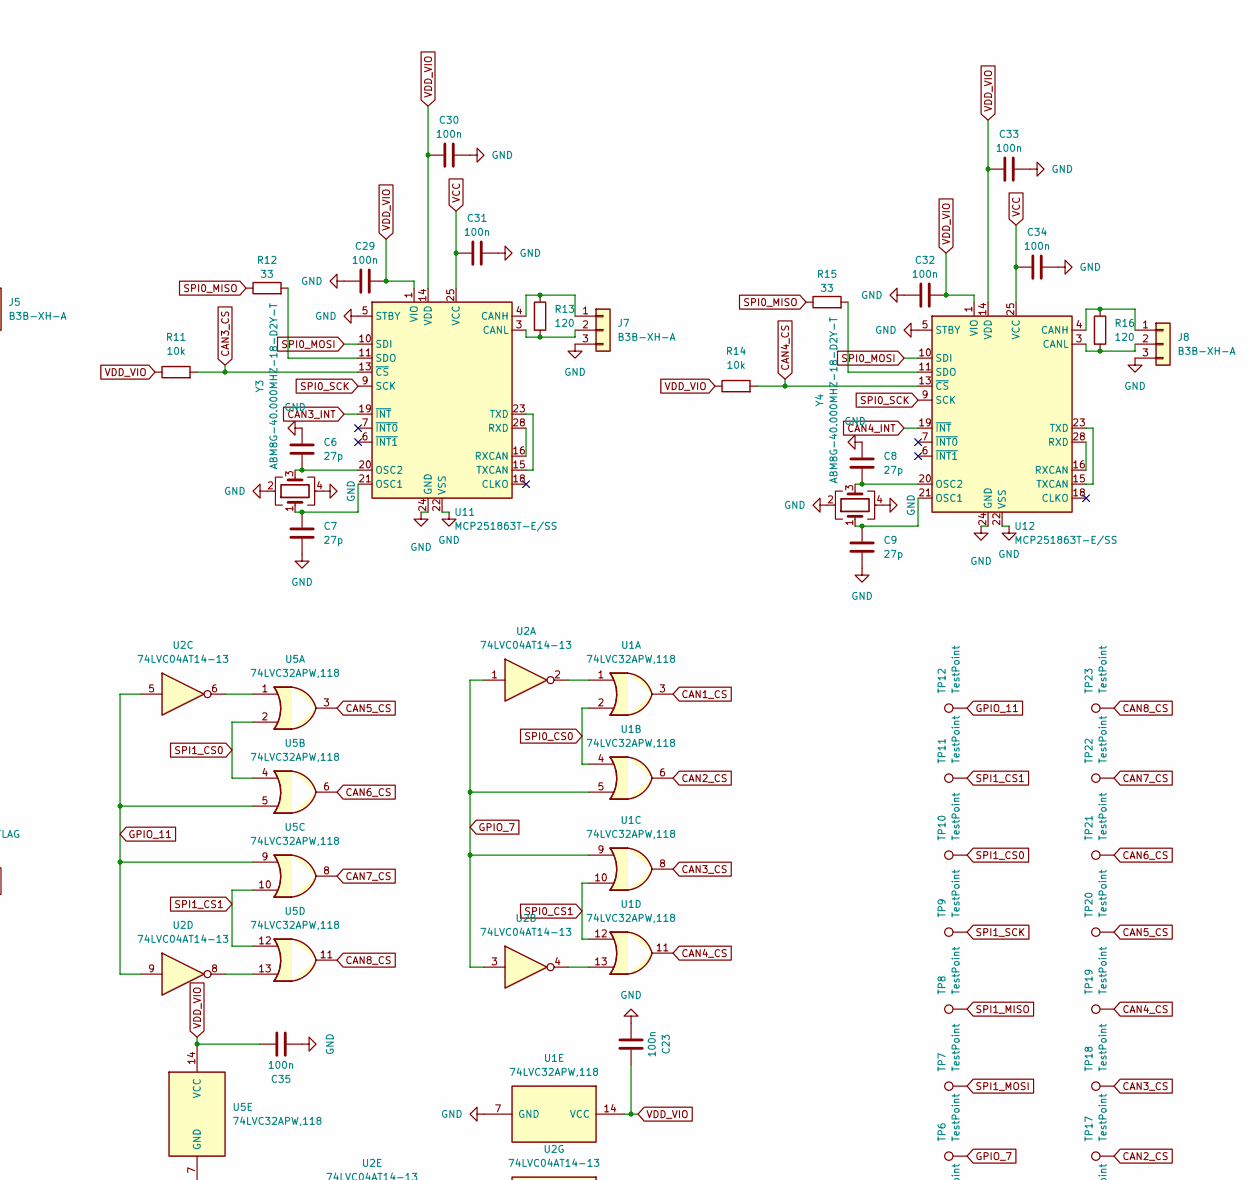
[picture p60: schematic breakout.kicad_sch, part in row 1, column 2]

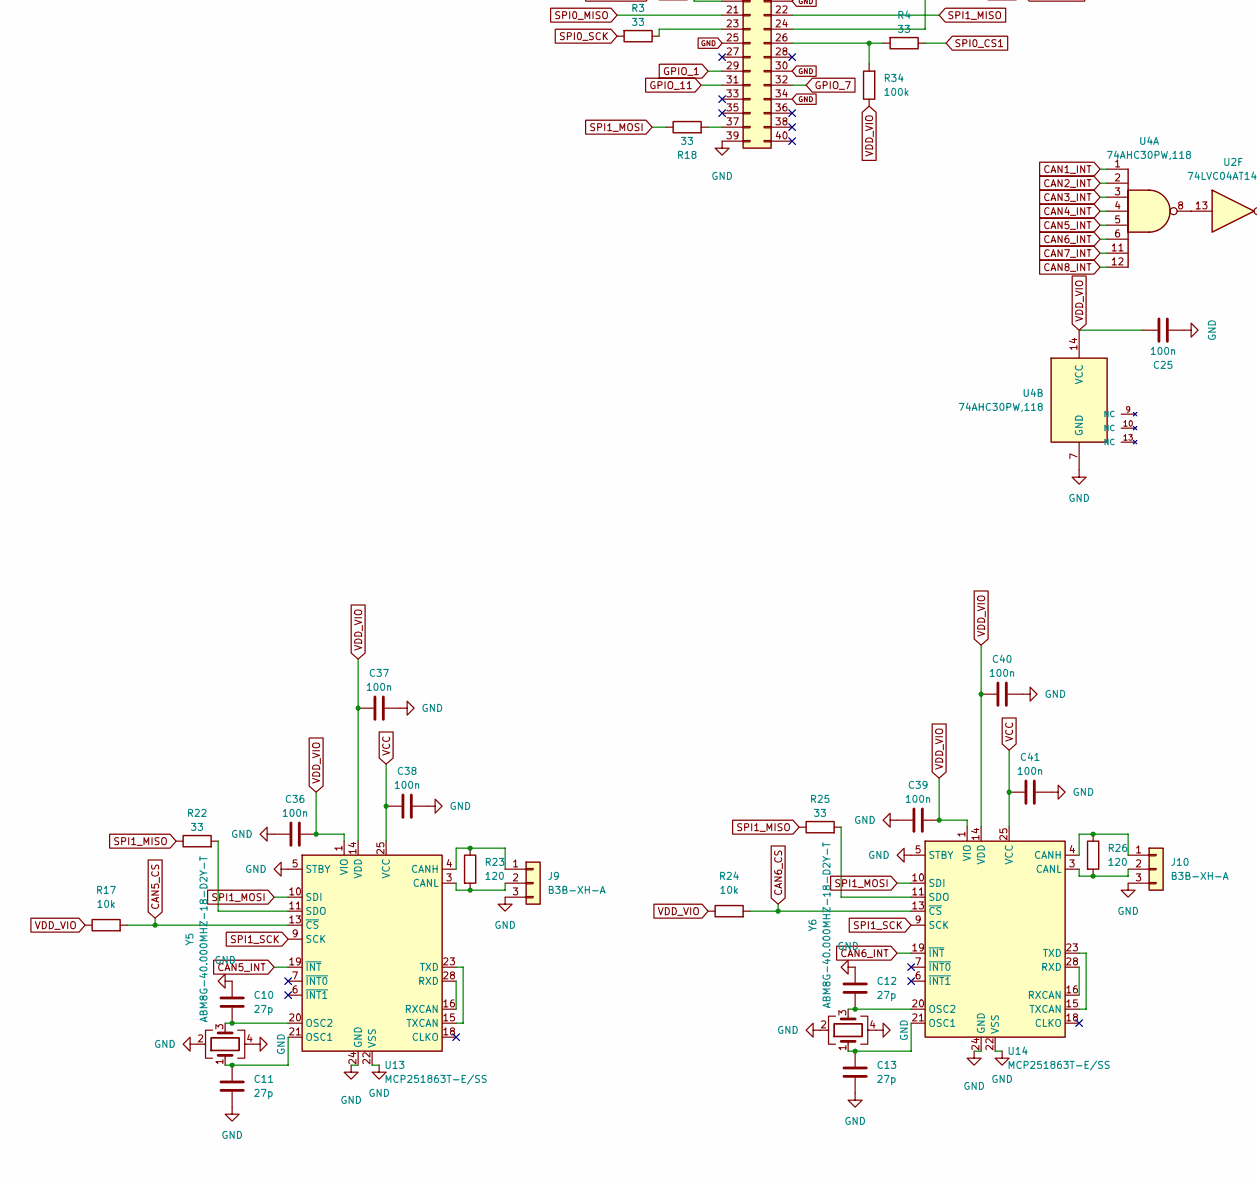
[picture p61: schematic breakout.kicad_sch, part in row 2, column 1]

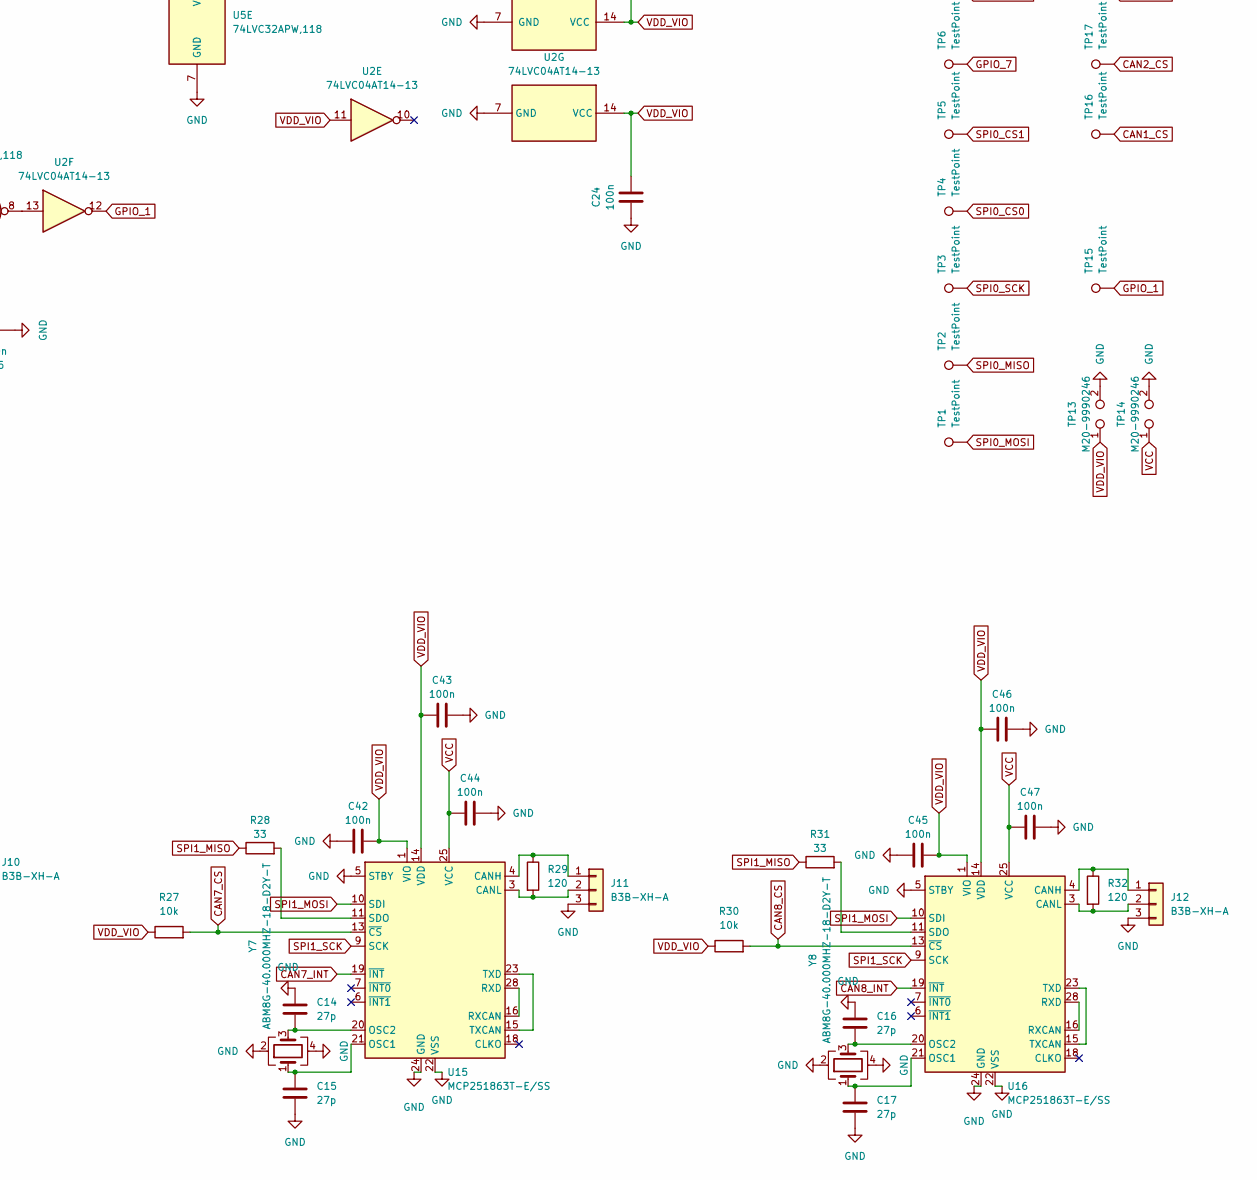
[picture p62: schematic breakout.kicad_sch, part in row 2, column 2]

Parts:
C1, C21, C22, C23, C24, C25, C26, C27, C28, C29, C30, C31, C32, C33, C34, C35, C36, C37, C38, C39, C40, C41, C42, C43, C44, C45, C46, C47: 100n; C_0603_1608Metric; MPN CC0603KRX7R9BB104
C2, C3, C4, C5, C6, C7, C8, C9, C10, C11, C12, C13, C14, C15, C16, C17: 27p; C_0603_1608Metric; MPN CL10C270JB8NNNC
C18, C19: 1u; C_0603_1608Metric; MPN CGA3E1X7R1E105K080AC
C20: 10u; C_0805_2012Metric; MPN CL21B106KOQNNNE
D2: BZT52C6V8-13-F; D_SOD-123; MPN BZT52C6V8-13-F
F1: 0466001.NR; Fuse_1206_3216Metric; MPN 0466001.NR
J1: M20-7832046; PinSocket_2x20_P2.54mm_Vertical; MPN M20-7832046
J4, J5, J7, J8, J9, J10, J11, J12: B3B-XH-A; JST_XH_B3B-XH-A_1x03_P2.50mm_Vertical; MPN B3B-XH-A
J6: B2B-XH-A; JST_XH_B2B-XH-A_1x02_P2.50mm_Vertical; MPN B2B-XH-A
Q1: AO3401A; SOT-23; MPN AO3401A
R1, R2, R3, R4, R5, R9, R12, R15, R18, R19, R20, R21, R22, R25, R28, R31: 33; R_0603_1608Metric; MPN RC0603FR-0733RL
R6, R10, R13, R16, R23, R26, R29, R32: 120; R_1206_3216Metric; MPN RC1206FR-07120RL
R7, R8, R11, R14, R17, R24, R27, R30, R38: 10k; R_0603_1608Metric; MPN RC0603FR-0710KL
R34, R35, R36, R37: 100k; R_0603_1608Metric; MPN RC0603FR-07100KL
TP1, TP2, TP3, TP4, TP5, TP6, TP7, TP8, TP9, TP10, TP11, TP12, TP15, TP16, TP17, TP18, TP19, TP20, TP21, TP22, TP23: TestPoint; TestPoint_Pad_D1.5mm
TP13, TP14: M20-9990246; PinHeader_1x02_P2.54mm_Vertical; MPN M20-9990246
U1, U5: 74LVC32APW,118; TSSOP-14_4.4x5mm_P0.65mm; MPN 74LVC32APW,118
U2: 74LVC04AT14-13; TSSOP-14_4.4x5mm_P0.65mm; MPN 74LVC04AT14-13
U3: TLV75533PDBVR; SOT-23-5; MPN TLV75533PDBVR
U4: 74AHC30PW,118; TSSOP-14_4.4x5mm_P0.65mm; MPN 74AHC30PW,118
U9, U10, U11, U12, U13, U14, U15, U16: MCP251863T-E/SS; SSOP-28_5.3x10.2mm_P0.65mm; MPN MCP251863T-E/SS
Y1, Y2, Y3, Y4, Y5, Y6, Y7, Y8: ABM8G-40.000MHZ-18-D2Y-T; Crystal_SMD_Abracon_ABM8G-4Pin_3.2x2.5mm; MPN ABM8G-40.000MHZ-18-D2Y-T

Connections:
CAN1_CS: R7.2, TP16.1 (1_1), U1.3, U9.13 (~CS)
CAN1_INT: U4.1, U9.19 (~INT)
CAN2_CS: R8.2, TP17.1 (1_1), U1.6, U10.13 (~CS)
CAN2_INT: U4.2, U10.19 (~INT)
CAN3_CS: R11.2, TP18.1 (1_1), U1.8, U11.13 (~CS)
CAN3_INT: U4.3, U11.19 (~INT)
CAN4_CS: R14.2, TP19.1 (1_1), U1.11, U12.13 (~CS)
CAN4_INT: U4.4, U12.19 (~INT)
CAN5_CS: R17.2, TP20.1 (1_1), U5.3, U13.13 (~CS)
CAN5_INT: U4.5, U13.19 (~INT)
CAN6_CS: R24.2, TP21.1 (1_1), U5.6, U14.13 (~CS)
CAN6_INT: U4.6, U14.19 (~INT)
CAN7_CS: R27.2, TP22.1 (1_1), U5.8, U15.13 (~CS)
CAN7_INT: U4.11, U15.19 (~INT)
CAN8_CS: R30.2, TP23.1 (1_1), U5.11, U16.13 (~CS)
CAN8_INT: U4.12, U16.19 (~INT)
GND: C1.1, C2.1, C3.2, C4.1, C5.2, C6.1, C7.2, C8.1, C9.2, C10.1, C11.2, C12.1, C13.2, C14.1, C15.2, C16.1, C17.2, C18.1, C19.1, C20.2, C21.1, C22.2, C23.2, C24.2, C25.2, C26.2, C27.1, C28.1, C29.2, C30.1, C31.1, C32.2, C33.1, C34.1, C35.2, C36.2, C37.1, C38.1, C39.2, C40.1, C41.1, C42.2, C43.1, C44.1, C45.2, C46.1, C47.1, J1.6, J1.9, J1.14, J1.20, J1.25, J1.30, J1.34, J1.39, J4.3, J5.3, J6.1, J7.3, J8.3, J9.3, J10.3, J11.3, J12.3, R38.2, TP13.2, TP14.2, U1.7 (GND), U2.7 (GND), U3.2 (GND), U4.7 (GND), U5.7 (GND), U9.5 (STBY), U9.22 (VSS), U9.24 (GND), U10.5 (STBY), U10.22 (VSS), U10.24 (GND), U11.5 (STBY), U11.22 (VSS), U11.24 (GND), U12.5 (STBY), U12.22 (VSS), U12.24 (GND), U13.5 (STBY), U13.22 (VSS), U13.24 (GND), U14.5 (STBY), U14.22 (VSS), U14.24 (GND), U15.5 (STBY), U15.22 (VSS), U15.24 (GND), U16.5 (STBY), U16.22 (VSS), U16.24 (GND), Y1.2, Y1.4, Y2.2, Y2.4, Y3.2, Y3.4, Y4.2, Y4.4, Y5.2, Y5.4, Y6.2, Y6.4, Y7.2, Y7.4, Y8.2, Y8.4
GPIO_1: J1.29, TP15.1 (1_1), U2.12
GPIO_7: J1.32, TP6.1 (1_1), U1.5, U1.9, U2.1, U2.3
GPIO_11: J1.31, TP12.1 (1_1), U2.5, U2.9, U5.5, U5.9
unnamed: D2.2 (A), Q1.1 (G), R38.1
unnamed: J1.13, R21.1
unnamed: J1.16, R20.2, R36.1
unnamed: J1.18, R19.2, R37.2
unnamed: J1.19, R1.1
unnamed: J1.23, R3.1
unnamed: J1.24, R5.2, R35.1
unnamed: J1.26, R4.2, R34.2
unnamed: J1.37, R18.2
unnamed: J4.1, R6.1, U9.4 (CANH)
unnamed: J4.2, R6.2, U9.3 (CANL)
unnamed: J5.1, R10.1, U10.4 (CANH)
unnamed: J5.2, R10.2, U10.3 (CANL)
unnamed: F1.2, J6.2
unnamed: J7.1, R13.1, U11.4 (CANH)
unnamed: J7.2, R13.2, U11.3 (CANL)
unnamed: J8.1, R16.1, U12.4 (CANH)
unnamed: J8.2, R16.2, U12.3 (CANL)
unnamed: J9.1, R23.1, U13.4 (CANH)
unnamed: J9.2, R23.2, U13.3 (CANL)
unnamed: J10.1, R26.1, U14.4 (CANH)
unnamed: J10.2, R26.2, U14.3 (CANL)
unnamed: J11.1, R29.1, U15.4 (CANH)
unnamed: J11.2, R29.2, U15.3 (CANL)
unnamed: J12.1, R32.1, U16.4 (CANH)
unnamed: J12.2, R32.2, U16.3 (CANL)
unnamed: F1.1, Q1.3 (D)
unnamed: U1.1, U2.2
unnamed: U1.13, U2.4
unnamed: U2.6, U5.1
unnamed: U2.8, U5.13
unnamed: U2.13, U4.8
unnamed: C3.1, U9.21 (OSC1), Y1.1
unnamed: C2.2, U9.20 (OSC2), Y1.3
unnamed: U9.16 (RXCAN), U9.28 (RXD)
unnamed: R2.2, U9.11 (SDO)
unnamed: U9.15 (TXCAN), U9.23 (TXD)
unnamed: C5.1, U10.21 (OSC1), Y2.1
unnamed: C4.2, U10.20 (OSC2), Y2.3
unnamed: U10.16 (RXCAN), U10.28 (RXD)
unnamed: R9.2, U10.11 (SDO)
unnamed: U10.15 (TXCAN), U10.23 (TXD)
unnamed: C7.1, U11.21 (OSC1), Y3.1
unnamed: C6.2, U11.20 (OSC2), Y3.3
unnamed: U11.16 (RXCAN), U11.28 (RXD)
unnamed: R12.2, U11.11 (SDO)
unnamed: U11.15 (TXCAN), U11.23 (TXD)
unnamed: C9.1, U12.21 (OSC1), Y4.1
unnamed: C8.2, U12.20 (OSC2), Y4.3
unnamed: U12.16 (RXCAN), U12.28 (RXD)
unnamed: R15.2, U12.11 (SDO)
unnamed: U12.15 (TXCAN), U12.23 (TXD)
unnamed: C11.1, U13.21 (OSC1), Y5.1
unnamed: C10.2, U13.20 (OSC2), Y5.3
unnamed: U13.16 (RXCAN), U13.28 (RXD)
unnamed: R22.2, U13.11 (SDO)
unnamed: U13.15 (TXCAN), U13.23 (TXD)
unnamed: C13.1, U14.21 (OSC1), Y6.1
unnamed: C12.2, U14.20 (OSC2), Y6.3
unnamed: U14.16 (RXCAN), U14.28 (RXD)
unnamed: R25.2, U14.11 (SDO)
unnamed: U14.15 (TXCAN), U14.23 (TXD)
unnamed: C15.1, U15.21 (OSC1), Y7.1
unnamed: C14.2, U15.20 (OSC2), Y7.3
unnamed: U15.16 (RXCAN), U15.28 (RXD)
unnamed: R28.2, U15.11 (SDO)
unnamed: U15.15 (TXCAN), U15.23 (TXD)
unnamed: C17.1, U16.21 (OSC1), Y8.1
unnamed: C16.2, U16.20 (OSC2), Y8.3
unnamed: U16.16 (RXCAN), U16.28 (RXD)
unnamed: R31.2, U16.11 (SDO)
unnamed: U16.15 (TXCAN), U16.23 (TXD)
SPI0_CS0: R5.1, TP4.1 (1_1), U1.2, U1.4
SPI0_CS1: R4.1, TP5.1 (1_1), U1.10, U1.12
SPI0_MISO: J1.21, R2.1, R9.1, R12.1, R15.1, TP2.1 (1_1)
SPI0_MOSI: R1.2, TP1.1 (1_1), U9.10 (SDI), U10.10 (SDI), U11.10 (SDI), U12.10 (SDI)
SPI0_SCK: R3.2, TP3.1 (1_1), U9.9 (SCK), U10.9 (SCK), U11.9 (SCK), U12.9 (SCK)
SPI1_CS0: R19.1, TP10.1 (1_1), U5.2, U5.4
SPI1_CS1: R20.1, TP11.1 (1_1), U5.10, U5.12
SPI1_MISO: J1.22, R22.1, R25.1, R28.1, R31.1, TP8.1 (1_1)
SPI1_MOSI: R18.1, TP7.1 (1_1), U13.10 (SDI), U14.10 (SDI), U15.10 (SDI), U16.10 (SDI)
SPI1_SCK: R21.2, TP9.1 (1_1), U13.9 (SCK), U14.9 (SCK), U15.9 (SCK), U16.9 (SCK)
VCC: C1.2, C18.2, C20.1, C28.2, C31.2, C34.2, C38.2, C41.2, C44.2, C47.2, D2.1 (K), Q1.2 (S), TP14.1, U3.1 (IN), U3.3 (EN), U9.25 (VCC), U10.25 (VCC), U11.25 (VCC), U12.25 (VCC), U13.25 (VCC), U14.25 (VCC), U15.25 (VCC), U16.25 (VCC)
VDD_VIO: C19.2, C21.2, C22.1, C23.1, C24.1, C25.1, C26.1, C27.2, C29.1, C30.2, C32.1, C33.2, C35.1, C36.1, C37.2, C39.1, C40.2, C42.1, C43.2, C45.1, C46.2, R7.1, R8.1, R11.1, R14.1, R17.1, R24.1, R27.1, R30.1, R34.1, R35.2, R36.2, R37.1, TP13.1, U1.14 (VCC), U2.11, U2.14 (VCC), U3.5 (OUT), U4.14 (VCC), U5.14 (VCC), U9.1 (VIO), U9.14 (VDD), U10.1 (VIO), U10.14 (VDD), U11.1 (VIO), U11.14 (VDD), U12.1 (VIO), U12.14 (VDD), U13.1 (VIO), U13.14 (VDD), U14.1 (VIO), U14.14 (VDD), U15.1 (VIO), U15.14 (VDD), U16.1 (VIO), U16.14 (VDD)

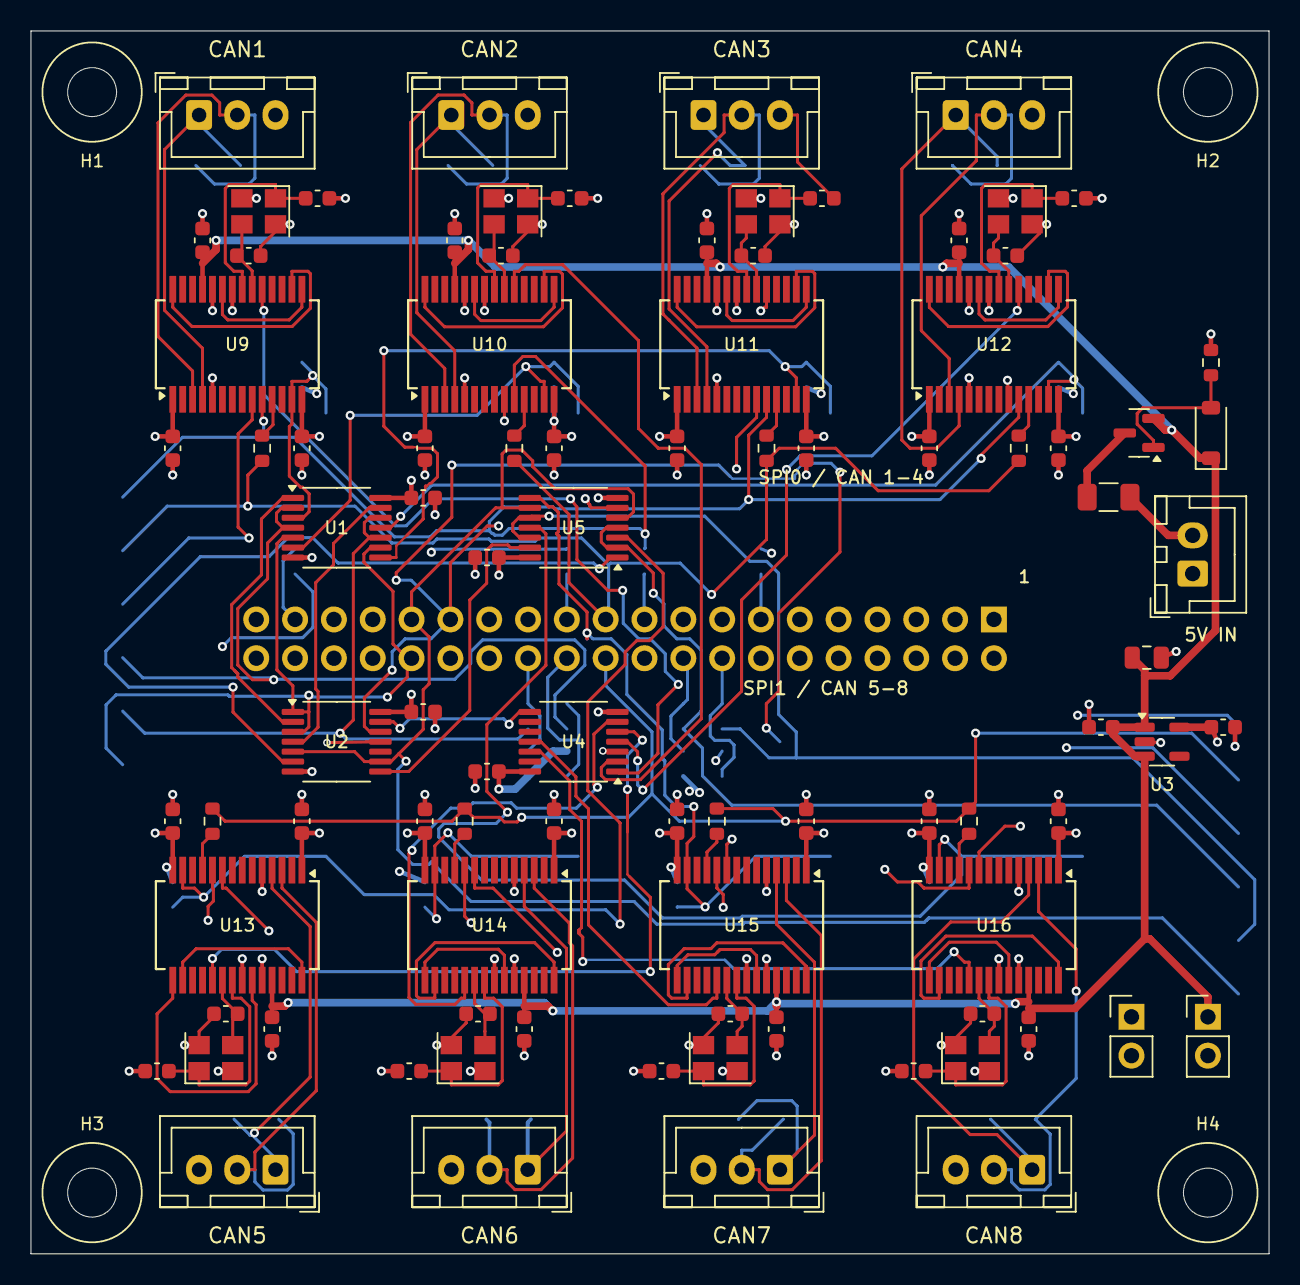
[picture p63: board breakout.kicad_pcb from above]

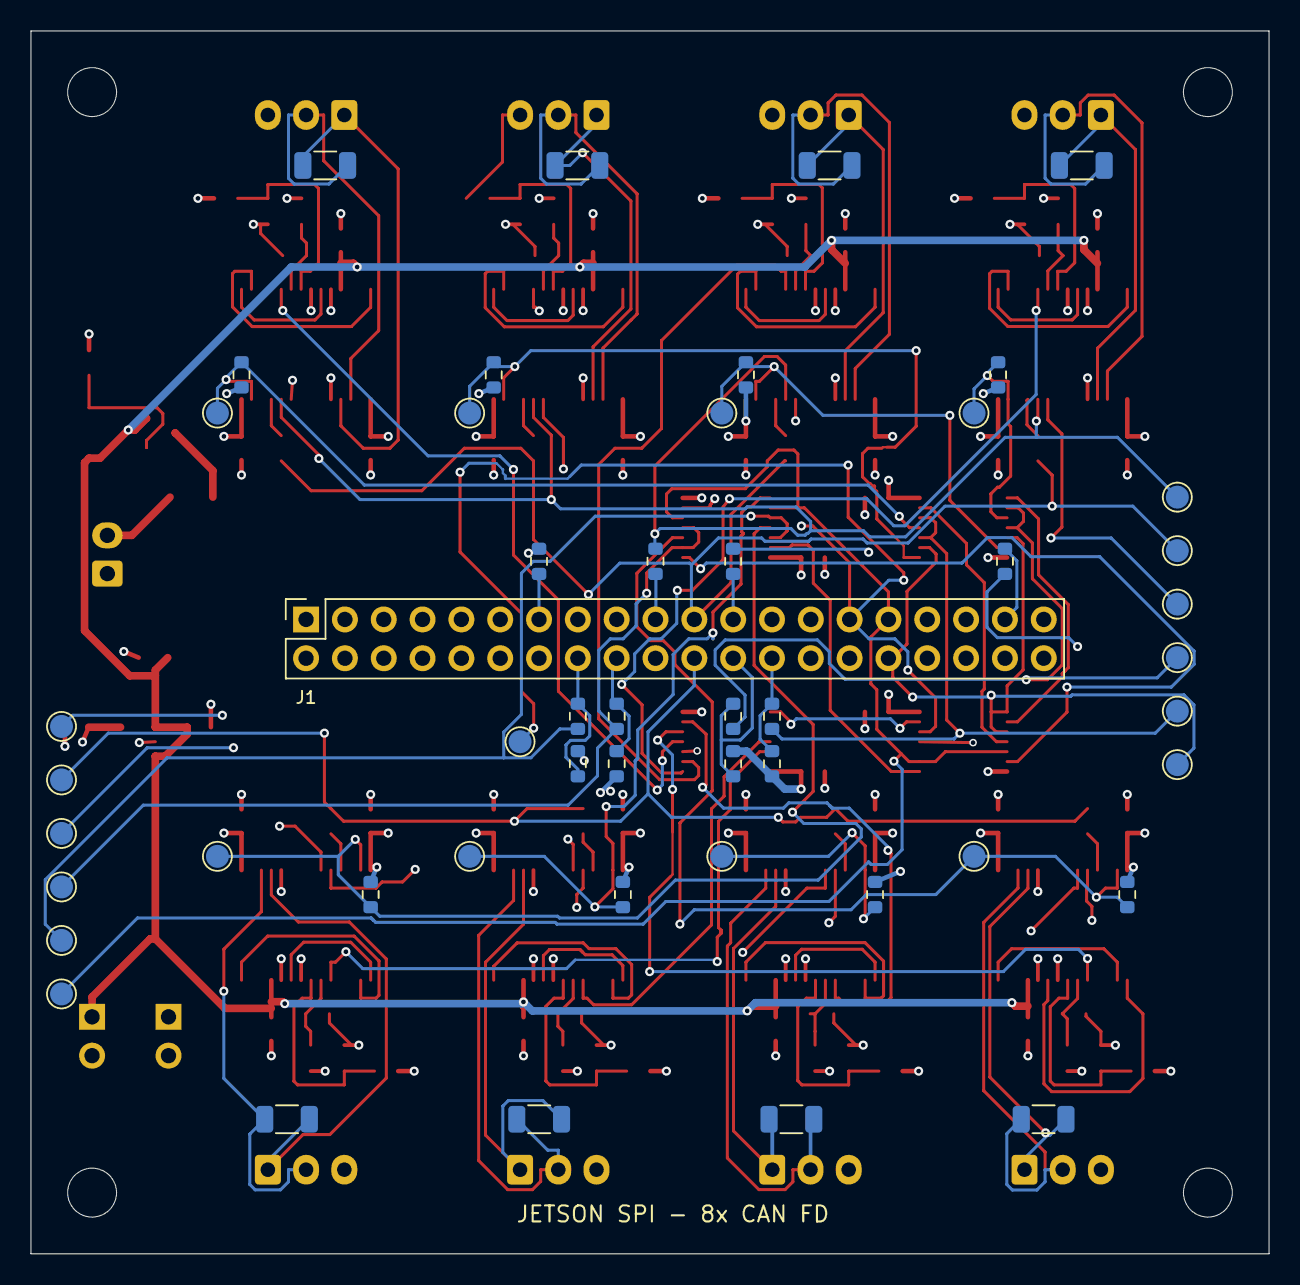
[picture p64: board breakout.kicad_pcb from below]

Board: 4 copper layers, 81.0 x 80.0 mm, 145 parts (50 on the bottom side), 104 nets.

Other parts of the board:
H1, H2, H3, H4: M3 mounting hole; MountingHole_3.2mm_M3_7mm_Keepout
