nischayhegde/jetson_spi_to_can_x8_breakout/(commit log)

2026-10-19 Fixed errors to pass ERC. Included no-connection-flags and pwr_flags. Also updated TXD pin on MCP251863T-E/SS to INPUT.
2026-10-23 Added SMD footprints and started on PCB Layout; currently established 4 PCB layers and started arranging components. Not finished; need to route all components + better organization
2026-10-25 Complete compact four-layer SPI-to-CAN board layout
    Arrange all 141 components on a 77 x 80 mm board, route every connection,
    place bypass capacitors beside their IC supply pins, and keep oscillator
    signals on the front copper without vias. Shorten SPI clock routes and
    document the layer use and route measurements.
    Keep schematic/ERC project settings, use portable project library paths,
    and remove two stray no-connect markers. Stop tracking KiCad lock files,
    local preferences and session history; ignore editor state and backups.
    Validation: KiCad 10.0.7 reports zero DRC violations, zero unconnected
    items, and zero schematic/PCB parity issues.
2026-10-26 Connect all Jetson J1 ground pins in schematic and PCB
2026-10-29 fixed footprints, created orderlist, added mounting holes
2026-10-30 substituted backordered components and created assembly guide
