nischayhegde/jetson_spi_to_can_x8_breakout/(notices)

Notices in the files:
kicad_footprints/3dmodels/PinSocket_2x20_P2.54mm_Vertical.step:
Copyright (C) 2024, KiCAD
This work is licensed under the
[Creative Commons CC-BY-SA 4.0 License](https://creativecommons.org/licenses/by-sa/4.0/legalcode),
with the following exception:
project files under this or any other license agreement. However, if you wish to distribute
